jagutic/SpiderBot/InformeTecnico/Imagenes/patas.png

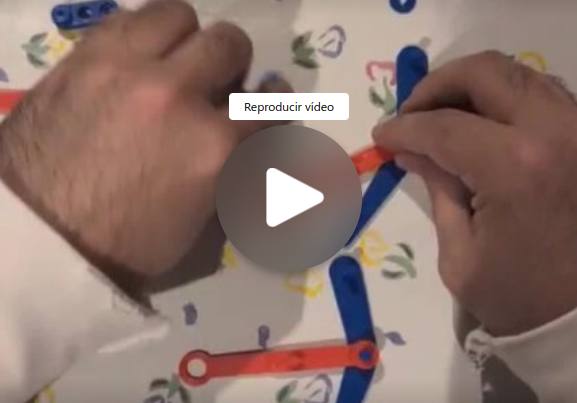
InformeTecnico/Imagenes/patas.png
