jagutic/SpiderBot/InformeTecnico/Imagenes/sim.png

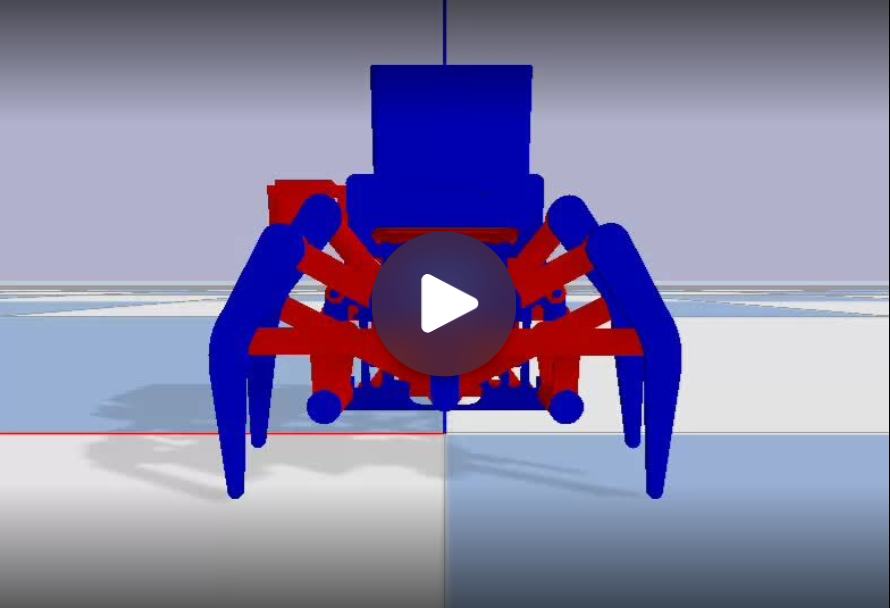
InformeTecnico/Imagenes/sim.png
