jagutic/SpiderBot/InformeTecnico/FreeCad_Stls/AxeMain.stl

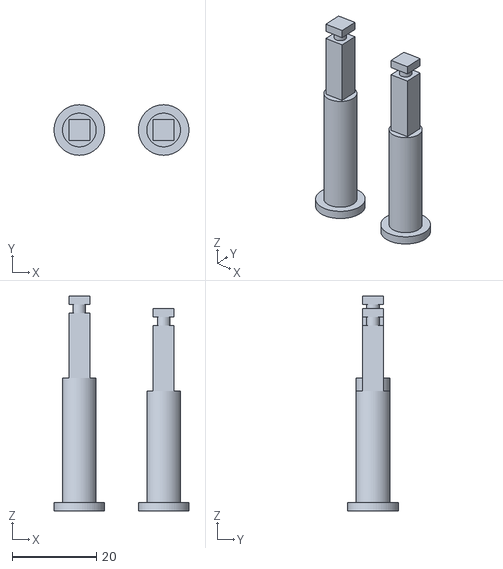
[picture p14: CAD file, 2026-01-07]
InformeTecnico/FreeCad_Stls/AxeMain.stl
32.0 x 12.0 x 51.0
