jagutic/SpiderBot/InformeTecnico/FreeCad_Stls/Medio.stl

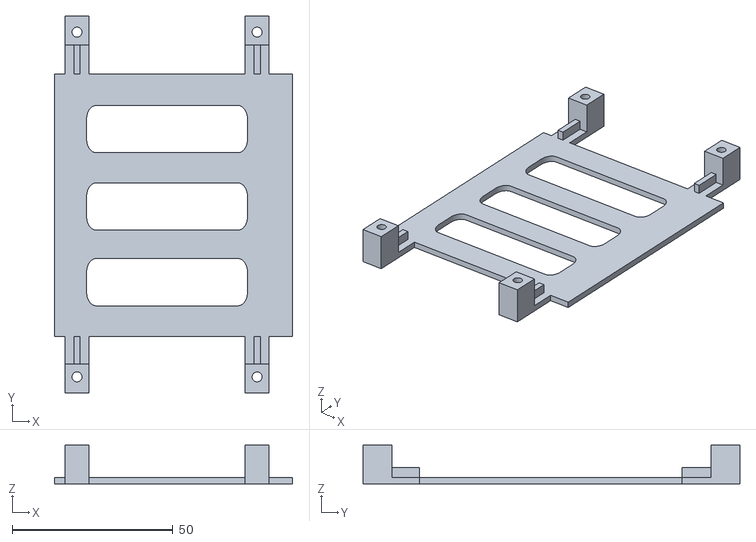
[picture p15: CAD file, 2026-01-09]
InformeTecnico/FreeCad_Stls/Medio.stl
74.0 x 117.2 x 12.0
