jagutic/SpiderBot/InformeTecnico/FreeCad_Stls/Base.stl

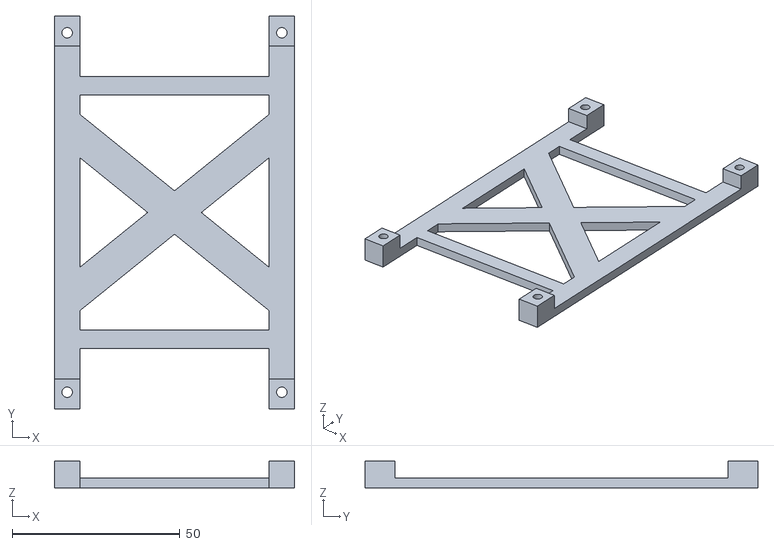
[picture p16: CAD file, 2026-01-09]
InformeTecnico/FreeCad_Stls/Base.stl
71.6 x 117.2 x 8.00
