jagutic/SpiderBot/InformeTecnico/FreeCad_Stls/Caja.stl

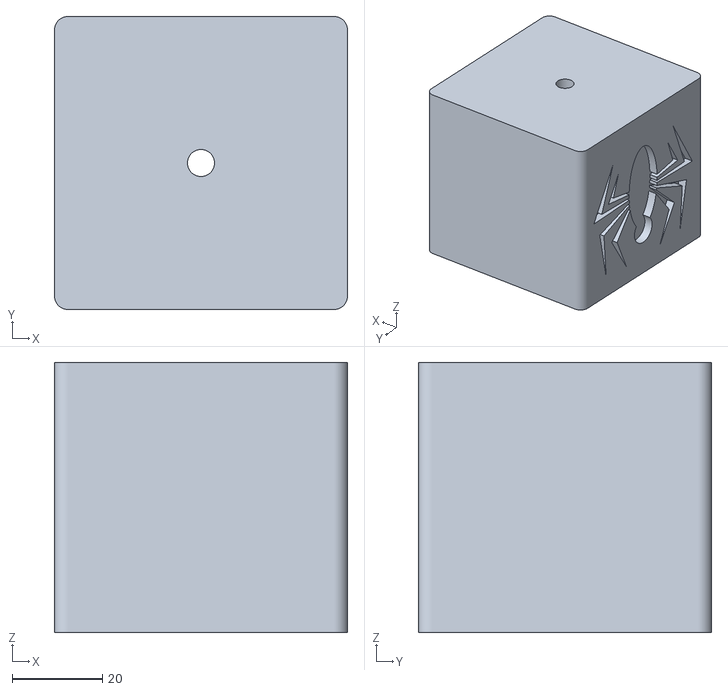
[picture p17: CAD file, 2026-01-07]
InformeTecnico/FreeCad_Stls/Caja.stl
65.0 x 65.0 x 60.0
