jagutic/SpiderBot/InformeTecnico/FreeCad_Stls/Der.stl

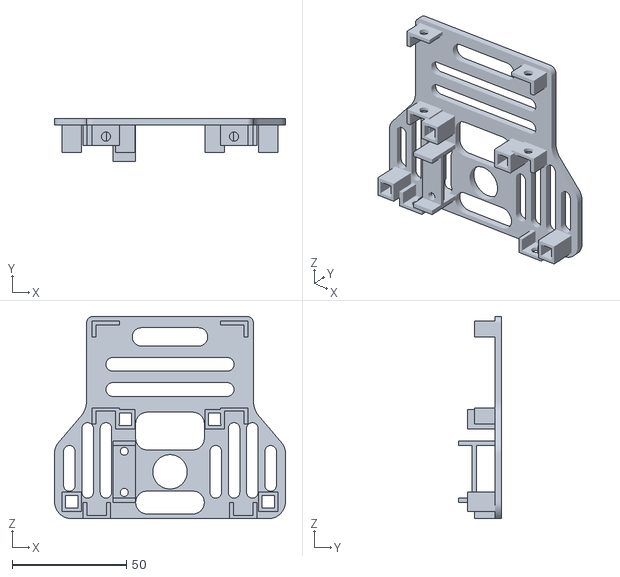
[picture p18: CAD file, 2026-01-07]
InformeTecnico/FreeCad_Stls/Der.stl
101.0 x 19.0 x 88.5
