jagutic/SpiderBot/InformeTecnico/FreeCad_Stls/Leg.stl

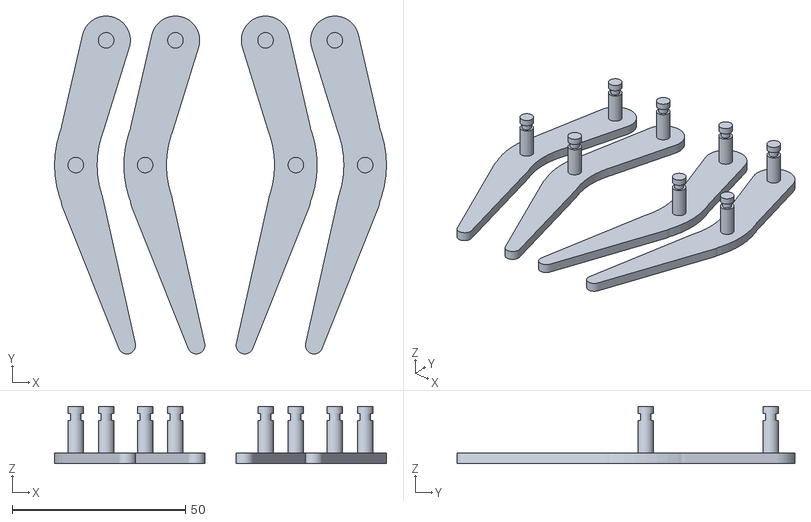
[picture p19: CAD file, 2026-01-07]
InformeTecnico/FreeCad_Stls/Leg.stl
95.8 x 97.5 x 16.5
