jagutic/SpiderBot/InformeTecnico/FreeCad_Stls/AxeDrive.stl

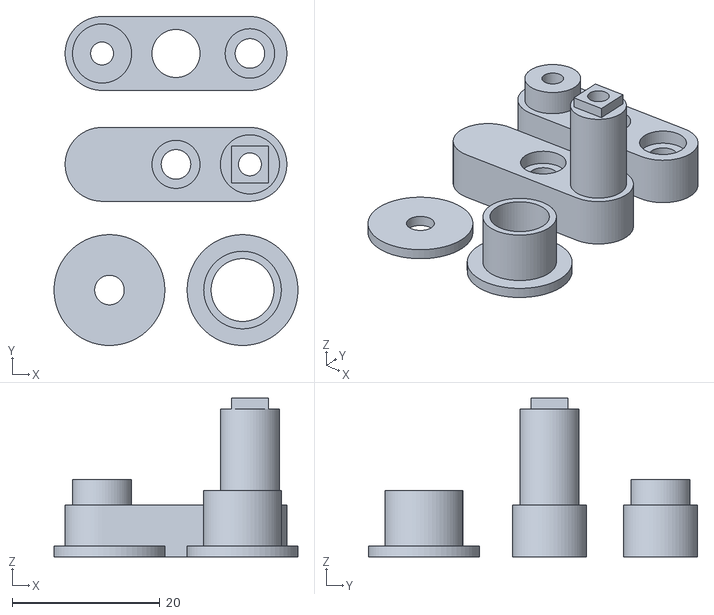
[picture p20: CAD file, 2026-01-07]
InformeTecnico/FreeCad_Stls/AxeDrive.stl
33.0 x 44.5 x 21.5
