jagutic/SpiderBot/InformeTecnico/FreeCad_Stls/Inks1.stl

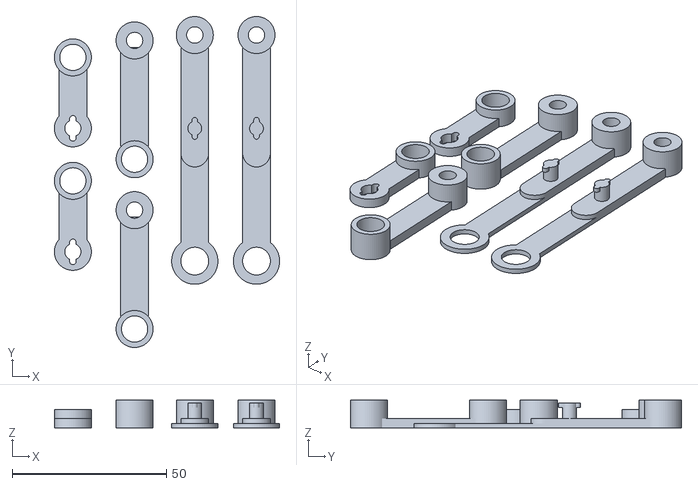
[picture p21: CAD file, 2026-01-07]
InformeTecnico/FreeCad_Stls/Inks1.stl
73.0 x 107.2 x 9.00
