jagutic/SpiderBot/InformeTecnico/FreeCad_Stls/Inks2.stl

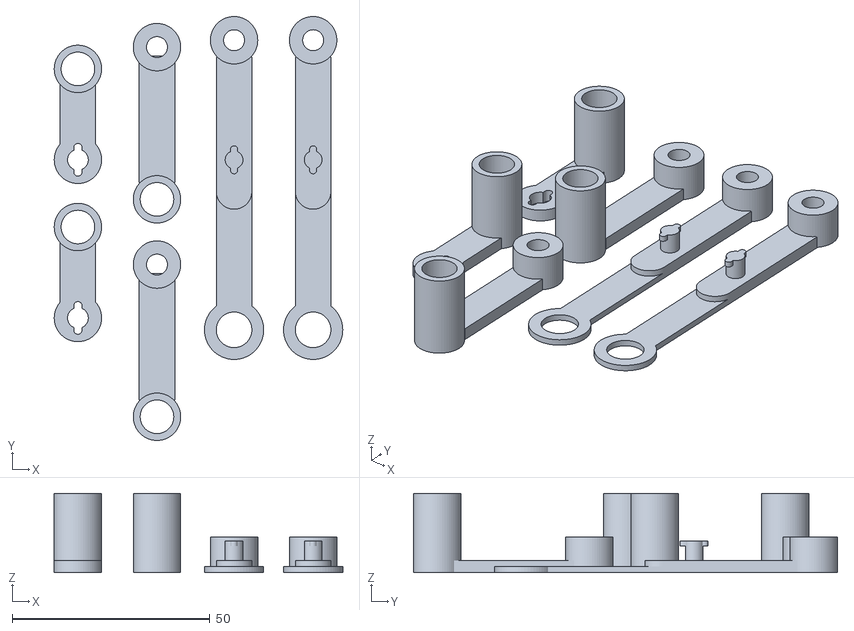
[picture p22: CAD file, 2026-01-07]
InformeTecnico/FreeCad_Stls/Inks2.stl
73.0 x 107.2 x 20.0
