jagutic/SpiderBot/InformeTecnico/FreeCad_Stls/AxeMtr.stl

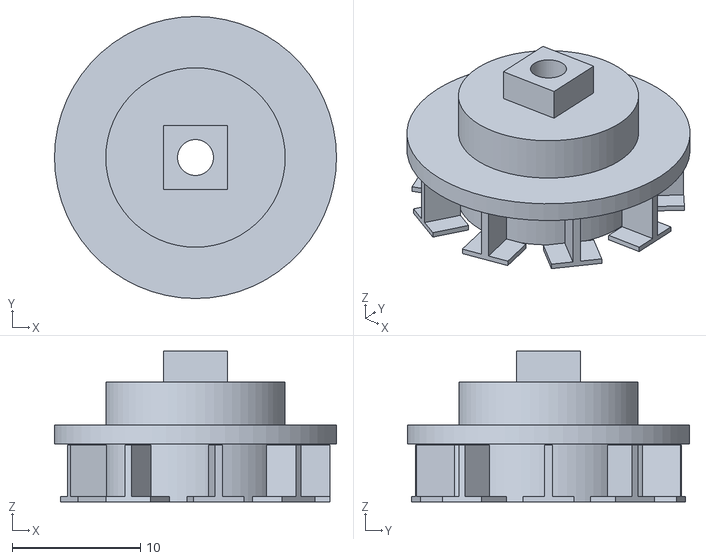
[picture p23: CAD file, 2026-01-07]
InformeTecnico/FreeCad_Stls/AxeMtr.stl
22.0 x 22.0 x 11.8
