jagutic/SpiderBot/InformeTecnico/FreeCad_Stls/Arriba.stl

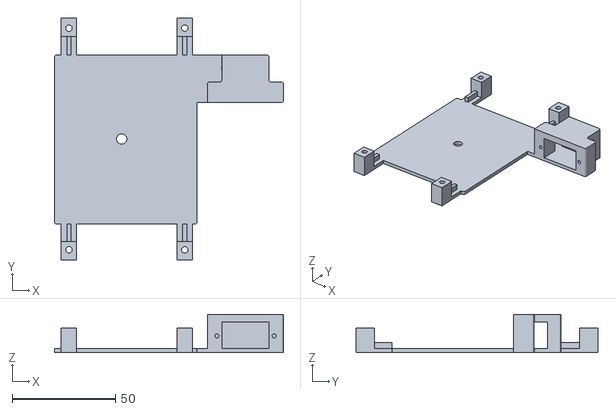
[picture p24: CAD file, 2026-01-07]
InformeTecnico/FreeCad_Stls/Arriba.stl
110.8 x 117.2 x 18.5
