jagutic/SpiderBot/InformeTecnico/FreeCad_Stls/ClipWasherBig.stl

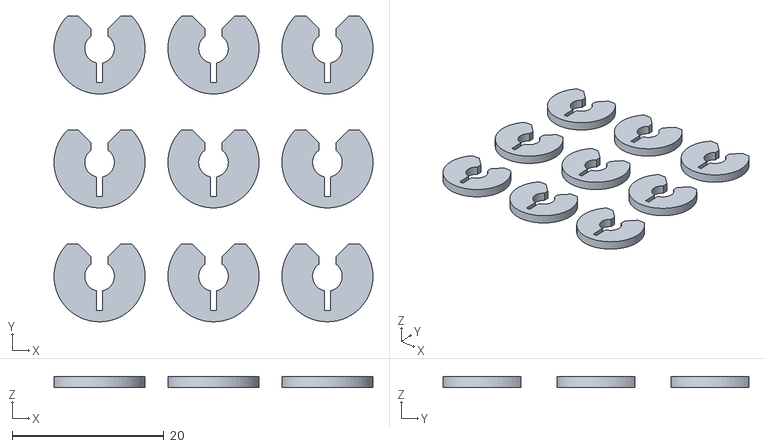
[picture p25: CAD file, 2026-01-07]
InformeTecnico/FreeCad_Stls/ClipWasherBig.stl
42.0 x 40.2 x 1.50
