jagutic/SpiderBot/InformeTecnico/FreeCad_Stls/ClipWasher.stl

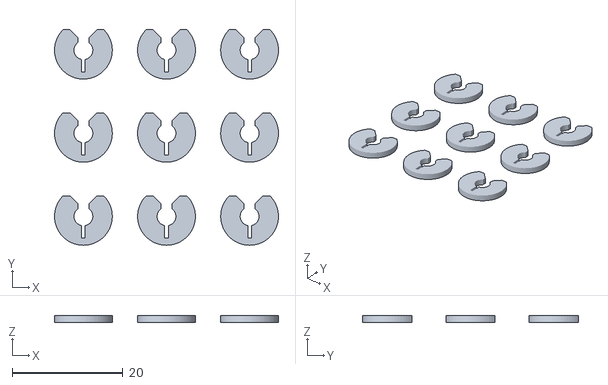
[picture p26: CAD file, 2026-01-07]
InformeTecnico/FreeCad_Stls/ClipWasher.stl
40.4 x 38.9 x 1.30
