jagutic/SpiderBot/(list of files, cad)

Other CAD files:
InformeTecnico/FreeCad_Stls/Izq.stl
