jagutic/SpiderBot/ManualUsuario/Imagenes/IR_Remote_Control.png

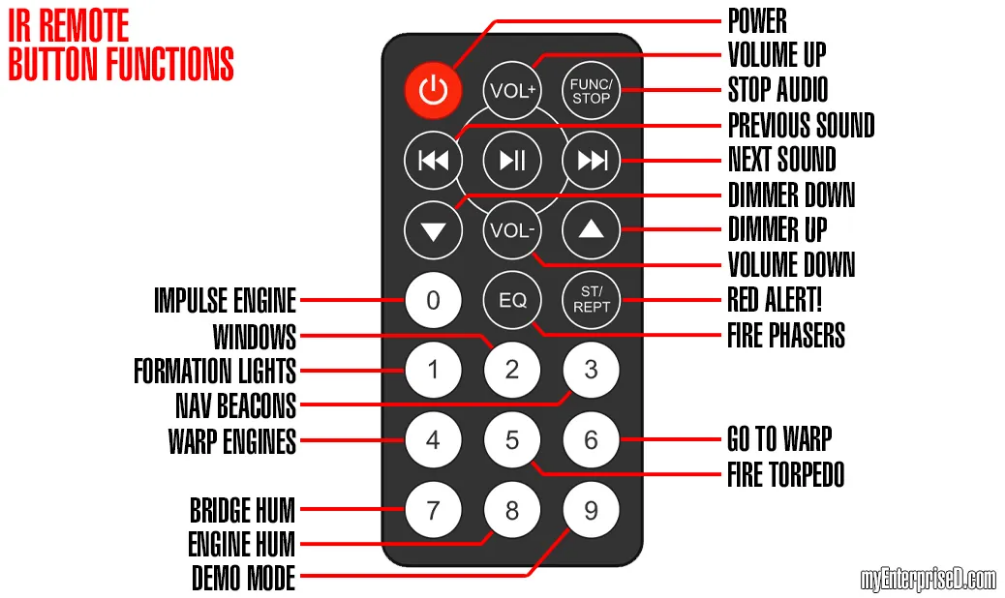
ManualUsuario/Imagenes/IR_Remote_Control.png
