jagutic/SpiderBot/InformeTecnico/simulacion/unnamed/urdf/unnamed.urdf

<robot name="unnamed" version="1.0">
  <joint name="Arriba_link_joint" type="fixed">
    <origin rpy="-3.14159 -0.00000 0.00000" xyz="0.00000 -0.00000 0.00100"/>
    <parent link="Caja_link"/>
    <child link="Arriba_link"/>
  </joint>
  <joint name="Caja_link_joint" type="fixed">
    <origin rpy="3.14159 -0.00000 0.00000" xyz="-0.00250 -0.00000 0.03850"/>
    <parent link="Medio_link"/>
    <child link="Caja_link"/>
  </joint>
  <joint name="Medio_link_joint" type="fixed">
    <origin rpy="0.00000 0.00000 0.00000" xyz="0.00000 0.00000 0.03350"/>
    <parent link="Base_link"/>
    <child link="Medio_link"/>
  </joint>
  <joint name="axe-drive_PCBWay Community.001_link_joint" type="fixed">
    <origin rpy="0.00000 -0.00000 1.57080" xyz="0.00000 0.00400 0.01140"/>
    <parent link="axe-mtr_left.001_link"/>
    <child link="axe-drive_PCBWay_Community.001_link"/>
  </joint>
  <joint name="axe-drive_PCBWay Community.002_link_joint" type="fixed">
    <origin rpy="0.00000 -0.00000 -0.00000" xyz="-0.00390 0.00000 0.01740"/>
    <parent link="axe-drive_PCBWay_Community.001_link"/>
    <child link="axe-drive_PCBWay_Community.002_link"/>
  </joint>
  <joint name="axe-drive_PCBWay Community.004_link_joint" type="fixed">
    <origin rpy="-0.00000 0.00000 -0.00000" xyz="-0.00390 -0.00000 0.01740"/>
    <parent link="axe-drive_PCBWay_Community.003_link"/>
    <child link="axe-drive_PCBWay_Community.004_link"/>
  </joint>
  <joint name="axe-drive_PCBWay_Community.003_link_joint" type="fixed">
    <origin rpy="3.14159 -0.00000 1.57080" xyz="-0.00000 0.00400 -0.01140"/>
    <parent link="axe-mtr_left_link"/>
    <child link="axe-drive_PCBWay_Community.003_link"/>
  </joint>
  <joint name="axe-main_PCBWay Community.001_link_joint" type="fixed">
    <origin rpy="-0.00000 0.00000 0.00000" xyz="-0.04399 -0.01757 -0.01136"/>
    <parent link="left_side_PCBWay_Community_link"/>
    <child link="axe-main_PCBWay_Community.001_link"/>
  </joint>
  <joint name="axe-main_PCBWay Community.003_link_joint" type="fixed">
    <origin rpy="0.00000 0.00000 0.00000" xyz="0.04201 -0.01757 -0.01136"/>
    <parent link="left_side_PCBWay_Community_link"/>
    <child link="axe-main_PCBWay_Community.003_link"/>
  </joint>
  <joint name="axe-main_PCBWay Community.004_link_joint" type="fixed">
    <origin rpy="-0.00000 0.00000 0.00000" xyz="0.01841 0.01833 -0.01246"/>
    <parent link="left_side_PCBWay_Community_link"/>
    <child link="axe-main_PCBWay_Community.004_link"/>
  </joint>
  <joint name="axe-main_PCBWay Community.005_link_joint" type="fixed">
    <origin rpy="-0.00000 -0.00000 -3.14159" xyz="-0.02072 -0.01850 -0.01237"/>
    <parent link="right_side_PCBWay_Community_link"/>
    <child link="axe-main_PCBWay_Community.005_link"/>
  </joint>
  <joint name="axe-main_PCBWay Community.006_link_joint" type="fixed">
    <origin rpy="-0.00000 -0.00000 -3.14159" xyz="0.01808 -0.01850 -0.01237"/>
    <parent link="right_side_PCBWay_Community_link"/>
    <child link="axe-main_PCBWay_Community.006_link"/>
  </joint>
  <joint name="axe-main_PCBWay Community.007_link_joint" type="fixed">
    <origin rpy="-0.00000 -0.00000 -3.14159" xyz="0.04168 0.01740 -0.01127"/>
    <parent link="right_side_PCBWay_Community_link"/>
    <child link="axe-main_PCBWay_Community.007_link"/>
  </joint>
  <joint name="axe-main_PCBWay Community_link_joint" type="fixed">
    <origin rpy="-0.00000 0.00000 0.00000" xyz="-0.02039 0.01833 -0.01246"/>
    <parent link="left_side_PCBWay_Community_link"/>
    <child link="axe-main_PCBWay_Community_link"/>
  </joint>
  <joint name="axe-main_PCBWay_Community.002_link_joint" type="fixed">
    <origin rpy="-0.00000 -0.00000 -3.14159" xyz="-0.04432 0.01740 -0.01127"/>
    <parent link="right_side_PCBWay_Community_link"/>
    <child link="axe-main_PCBWay_Community.002_link"/>
  </joint>
  <joint name="axe-mtr_left.001_link_joint" type="continuous">
    <limit lower="0" upper="0" effort="0.00000" velocity="0.00000"/>
    <origin rpy="3.14159 0.00000 3.14159" xyz="-0.00132 0.00440 0.00053"/>
    <parent link="right_side_PCBWay_Community_link"/>
    <child link="axe-mtr_left.001_link"/>
    <axis xyz="0.00000 0.00000 1.00000"/>
  </joint>
  <joint name="axe-mtr_left_link_joint" type="continuous">
    <limit lower="0" upper="0" effort="0.00000" velocity="1000.00000"/>
    <origin rpy="0.00000 -0.00000 3.14159" xyz="-0.00099 -0.00457 0.00044"/>
    <parent link="left_side_PCBWay_Community_link"/>
    <child link="axe-mtr_left_link"/>
    <axis xyz="0.00000 0.00000 1.00000"/>
  </joint>
  <joint name="inks_1_PCBWay Community.001_link_joint" type="continuous">
    <limit lower="0" upper="0" effort="0.00000" velocity="0.00000"/>
    <origin rpy="-0.00000 0.00000 -0.68167" xyz="-0.00003 0.00019 0.00561"/>
    <parent link="axe-main_PCBWay_Community.005_link"/>
    <child link="inks_1_PCBWay_Community.001_link"/>
    <axis xyz="0.00000 0.00000 1.00000"/>
  </joint>
  <joint name="inks_1_PCBWay Community.003_link_joint" type="continuous">
    <limit lower="0" upper="0" effort="0.00000" velocity="1000.00000"/>
    <origin rpy="3.14159 -0.00000 -2.45992" xyz="-0.00003 0.00019 0.00561"/>
    <parent link="axe-main_PCBWay_Community.004_link"/>
    <child link="inks_1_PCBWay_Community.003_link"/>
    <axis xyz="0.00000 0.00000 1.00000"/>
  </joint>
  <joint name="inks_1_PCBWay Community.004_link_joint" type="continuous">
    <limit lower="0" upper="0" effort="0.00000" velocity="0.00000"/>
    <origin rpy="0.00000 0.00000 0.68168" xyz="0.00003 0.00019 0.00561"/>
    <parent link="axe-main_PCBWay_Community_link"/>
    <child link="inks_1_PCBWay_Community.004_link"/>
    <axis xyz="0.00000 0.00000 1.00000"/>
  </joint>
  <joint name="inks_1_PCBWay Community.005_link_joint" type="continuous">
    <limit lower="0" upper="0" effort="0.00000" velocity="0.00000"/>
    <origin rpy="-0.00000 -0.00000 -2.95933" xyz="0.00021 -0.00008 0.00567"/>
    <parent link="axe-main_PCBWay_Community.003_link"/>
    <child link="inks_1_PCBWay_Community.005_link"/>
    <axis xyz="0.00000 0.00000 1.00000"/>
  </joint>
  <joint name="inks_1_PCBWay Community.006_link_joint" type="continuous">
    <limit lower="0" upper="0" effort="0.00000" velocity="0.00000"/>
    <origin rpy="3.14159 0.00000 2.95933" xyz="-0.00019 0.00009 0.01292"/>
    <parent link="inks_2_PCBWay_Community.006_link"/>
    <child link="inks_1_PCBWay_Community.006_link"/>
    <axis xyz="0.00000 0.00000 1.00000"/>
  </joint>
  <joint name="inks_1_PCBWay Community.008_link_joint" type="continuous">
    <limit lower="0" upper="0" effort="0.00000" velocity="0.00000"/>
    <origin rpy="-0.00000 -0.00000 2.95933" xyz="-0.00021 -0.00000 0.00467"/>
    <parent link="axe-main_PCBWay_Community.001_link"/>
    <child link="inks_1_PCBWay_Community.008_link"/>
    <axis xyz="0.00000 0.00000 1.00000"/>
  </joint>
  <joint name="inks_1_PCBWay Community.009_link_joint" type="continuous">
    <limit lower="0" upper="0" effort="0.00000" velocity="0.00000"/>
    <origin rpy="-0.00000 -0.00000 2.95933" xyz="-0.00021 -0.00000 0.00467"/>
    <parent link="axe-main_PCBWay_Community.007_link"/>
    <child link="inks_1_PCBWay_Community.009_link"/>
    <axis xyz="0.00000 0.00000 1.00000"/>
  </joint>
  <joint name="inks_1_PCBWay Community.010_link_joint" type="continuous">
    <limit lower="0" upper="0" effort="0.00000" velocity="0.00000"/>
    <origin rpy="0.00000 -0.00000 2.22205" xyz="-0.00000 0.00000 0.00000"/>
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
    <child link="inks_2_PCBWay_Community.008_link"/>
    <axis xyz="0.00000 0.00000 1.00000"/>
  </joint>
  <joint name="inks_2_PCBWay Community.009_link_joint" type="continuous">
    <limit lower="0" upper="0" effort="0.00000" velocity="0.00000"/>
    <origin rpy="3.14159 -0.00000 0.00000" xyz="-0.00002 0.00001 -0.00725"/>
    <parent link="axe-main_PCBWay_Community.001_link"/>
    <child link="inks_2_PCBWay_Community.009_link"/>
    <axis xyz="0.00000 0.00000 1.00000"/>
  </joint>
  <joint name="inks_2_PCBWay Community.010_link_joint" type="continuous">
    <limit lower="0" upper="0" effort="0.00000" velocity="0.00000"/>
    <origin rpy="0.00000 0.00000 3.14159" xyz="-0.01011 0.00000 0.00455"/>
    <parent link="axe-drive_PCBWay_Community.002_link"/>
    <child link="inks_2_PCBWay_Community.010_link"/>
    <axis xyz="0.00000 0.00000 1.00000"/>
  </joint>
  <joint name="inks_2_PCBWay Community.012_link_joint" type="continuous">
    <limit lower="0" upper="0" effort="0.00000" velocity="0.00000"/>
    <origin rpy="-0.00000 0.00000 3.14159" xyz="-0.00002 0.00001 -0.00725"/>
    <parent link="axe-main_PCBWay_Community.007_link"/>
    <child link="inks_2_PCBWay_Community.012_link"/>
    <axis xyz="0.00000 0.00000 1.00000"/>
  </joint>
  <joint name="inks_2_PCBWay_Community.001_link_joint" type="continuous">
    <limit lower="0" upper="0" effort="0.00000" velocity="0.00000"/>
    <origin rpy="-3.14159 0.00000 -0.00000" xyz="-0.01011 0.00000 0.00300"/>
    <parent link="axe-drive_PCBWay_Community.004_link"/>
    <child link="inks_2_PCBWay_Community.001_link"/>
    <axis xyz="0.00000 0.00000 1.00000"/>
  </joint>
  <joint name="inks_2_PCBWay_Community.011_link_joint" type="continuous">
    <limit lower="0" upper="0" effort="0.00000" velocity="0.00000"/>
    <origin rpy="-3.14159 -0.00000 2.06821" xyz="0.00003 -0.00011 -0.01890"/>
    <parent link="axe-main_PCBWay_Community.006_link"/>
    <child link="inks_2_PCBWay_Community.011_link"/>
    <axis xyz="0.00000 0.00000 1.00000"/>
  </joint>
  <joint name="left_side_PCBWay_Community_link_joint" type="fixed">
    <origin rpy="1.57080 0.00000 0.00000" xyz="0.00099 0.05864 0.02357"/>
    <parent link="Base_link"/>
    <child link="left_side_PCBWay_Community_link"/>
  </joint>
  <joint name="leg_PCBWay Community.001_link_joint" type="continuous">
    <limit lower="0" upper="0" effort="0.00000" velocity="1000.00000"/>
    <origin rpy="-0.00000 0.00000 1.51844" xyz="0.00021 0.07365 0.01349"/>
    <parent link="inks_1_PCBWay_Community.002_link"/>
    <child link="leg_PCBWay_Community.001_link"/>
    <axis xyz="0.00000 0.00000 1.00000"/>
  </joint>
  <joint name="leg_PCBWay Community.002_link_joint" type="continuous">
    <limit lower="0" upper="0" effort="0.00000" velocity="0.00000"/>
    <origin rpy="-0.00000 -0.00000 -1.52909" xyz="-0.00021 0.07365 0.01349"/>
    <parent link="inks_1_PCBWay_Community.010_link"/>
    <child link="leg_PCBWay_Community.002_link"/>
    <axis xyz="0.00000 0.00000 1.00000"/>
  </joint>
  <joint name="leg_PCBWay Community.004_link_joint" type="continuous">
    <limit lower="0" upper="0" effort="0.00000" velocity="0.00000"/>
    <origin rpy="-0.00000 0.00000 1.51844" xyz="0.00021 0.07365 0.01349"/>
    <parent link="inks_1_PCBWay_Community.012_link"/>
    <child link="leg_PCBWay_Community.004_link"/>
    <axis xyz="0.00000 0.00000 1.00000"/>
  </joint>
  <joint name="leg_PCBWay Community.005_link_joint" type="continuous">
    <limit lower="0" upper="0" effort="0.00000" velocity="0.00000"/>
    <origin rpy="-3.14159 0.00000 1.23744" xyz="-0.00000 -0.07325 -0.01380"/>
    <parent link="inks_2_PCBWay_Community.007_link"/>
    <child link="leg_PCBWay_Community.005_link"/>
    <axis xyz="0.00000 0.00000 1.00000"/>
  </joint>
  <joint name="leg_PCBWay Community.006_link_joint" type="continuous">
    <limit lower="0" upper="0" effort="0.00000" velocity="0.00000"/>
    <origin rpy="-3.14159 0.00000 2.44863" xyz="0.05845 -0.04482 -0.01349"/>
    <parent link="inks_1_PCBWay_Community.011_link"/>
    <child link="leg_PCBWay_Community.006_link"/>
    <axis xyz="0.00000 0.00000 1.00000"/>
  </joint>
  <joint name="leg_PCBWay Community.007_link_joint" type="continuous">
    <limit lower="0" upper="0" effort="0.00000" velocity="0.00000"/>
    <origin rpy="0.00000 0.00000 1.90415" xyz="0.00000 0.07325 0.01225"/>
    <parent link="inks_2_PCBWay_Community.003_link"/>
    <child link="leg_PCBWay_Community.007_link"/>
    <axis xyz="0.00000 0.00000 1.00000"/>
  </joint>
  <joint name="leg_PCBWay Community.008_link_joint" type="continuous">
    <limit lower="0" upper="0" effort="0.00000" velocity="0.00000"/>
    <origin rpy="-3.14159 -0.00000 1.23744" xyz="-0.00000 -0.07325 -0.01380"/>
    <parent link="inks_2_PCBWay_Community.010_link"/>
    <child link="leg_PCBWay_Community.008_link"/>
    <axis xyz="0.00000 0.00000 1.00000"/>
  </joint>
  <joint name="leg_PCBWay_Community.003_link_joint" type="continuous">
    <limit lower="0" upper="0" effort="0.00000" velocity="0.00000"/>
    <origin rpy="0.00000 0.00000 1.90415" xyz="0.00000 0.07325 0.01225"/>
    <parent link="inks_2_PCBWay_Community.001_link"/>
    <child link="leg_PCBWay_Community.003_link"/>
    <axis xyz="0.00000 0.00000 1.00000"/>
  </joint>
  <joint name="right_side_PCBWay Community_link_joint" type="fixed">
    <origin rpy="-1.57080 0.00000 0.00000" xyz="0.00132 -0.05873 0.02340"/>
    <parent link="Base_link"/>
    <child link="right_side_PCBWay_Community_link"/>
  </joint>
  <link name="Arriba_link">
    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
  </link>
  <link name="Base_link">
    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
    <inertial>
      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
      <origin rpy="0.00000 0.00000 0.00000" xyz="0.00001 -0.00000 0.00189"/>
      <mass value="0.10000"/>
    </inertial>
    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
  </link>
  <link name="Caja_link">
    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
  </link>
  <link name="Medio_link">
    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
    <inertial>
      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
      <origin rpy="0.00000 0.00000 0.00000" xyz="0.00213 -0.00002 0.00231"/>
      <mass value="20.00000"/>
    </inertial>
    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
  </link>
  <link name="axe-drive_PCBWay_Community.001_link">
    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
    <inertial>
      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
      <origin rpy="0.00000 0.00000 0.00000" xyz="-0.00170 0.00000 -0.00150"/>
      <mass value="0.10000"/>
    </inertial>
    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
  </link>
  <link name="axe-drive_PCBWay_Community.002_link">
    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
    <inertial>
      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
      <origin rpy="0.00000 0.00000 0.00000" xyz="-0.00169 0.00000 -0.00105"/>
      <mass value="0.10000"/>
    </inertial>
    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
  </link>
  <link name="axe-drive_PCBWay_Community.003_link">
    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
    <inertial>
      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
      <origin rpy="0.00000 0.00000 0.00000" xyz="-0.00170 0.00000 -0.00150"/>
      <mass value="0.10000"/>
    </inertial>
    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
  </link>
  <link name="axe-drive_PCBWay_Community.004_link">
    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
    <inertial>
      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
      <origin rpy="0.00000 0.00000 0.00000" xyz="-0.00169 0.00000 -0.00105"/>
      <mass value="0.10000"/>
    </inertial>
    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
  </link>
  <link name="axe-main_PCBWay_Community.001_link">
    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
    <inertial>
      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
      <origin rpy="0.00000 0.00000 0.00000" xyz="0.00000 -0.00000 -0.00262"/>
      <mass value="0.10000"/>
    </inertial>
    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
  </link>
  <link name="axe-main_PCBWay_Community.002_link">
    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
    <inertial>
      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
      <origin rpy="0.00000 0.00000 0.00000" xyz="-0.00000 0.00000 -0.00262"/>
      <mass value="0.10000"/>
    </inertial>
    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
  </link>
  <link name="axe-main_PCBWay_Community.003_link">
    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
    <inertial>
      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
      <origin rpy="0.00000 0.00000 0.00000" xyz="0.00000 0.00000 -0.00262"/>
      <mass value="0.10000"/>
    </inertial>
    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
  </link>
  <link name="axe-main_PCBWay_Community.004_link">
    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
    <inertial>
      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
      <origin rpy="0.00000 0.00000 0.00000" xyz="0.00000 0.00000 -0.00277"/>
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
      <mass value="0.10000"/>
    </inertial>
    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
  </link>
  <link name="right_side_PCBWay_Community_link">
    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
    <inertial>
      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
      <origin rpy="0.00000 0.00000 0.00000" xyz="-0.00229 -0.01470 0.00004"/>
      <mass value="0.10000"/>
    </inertial>
    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
  </link>
  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
</robot>
