jagutic/SpiderBot/InformeTecnico/Planos/All-Page.pdf

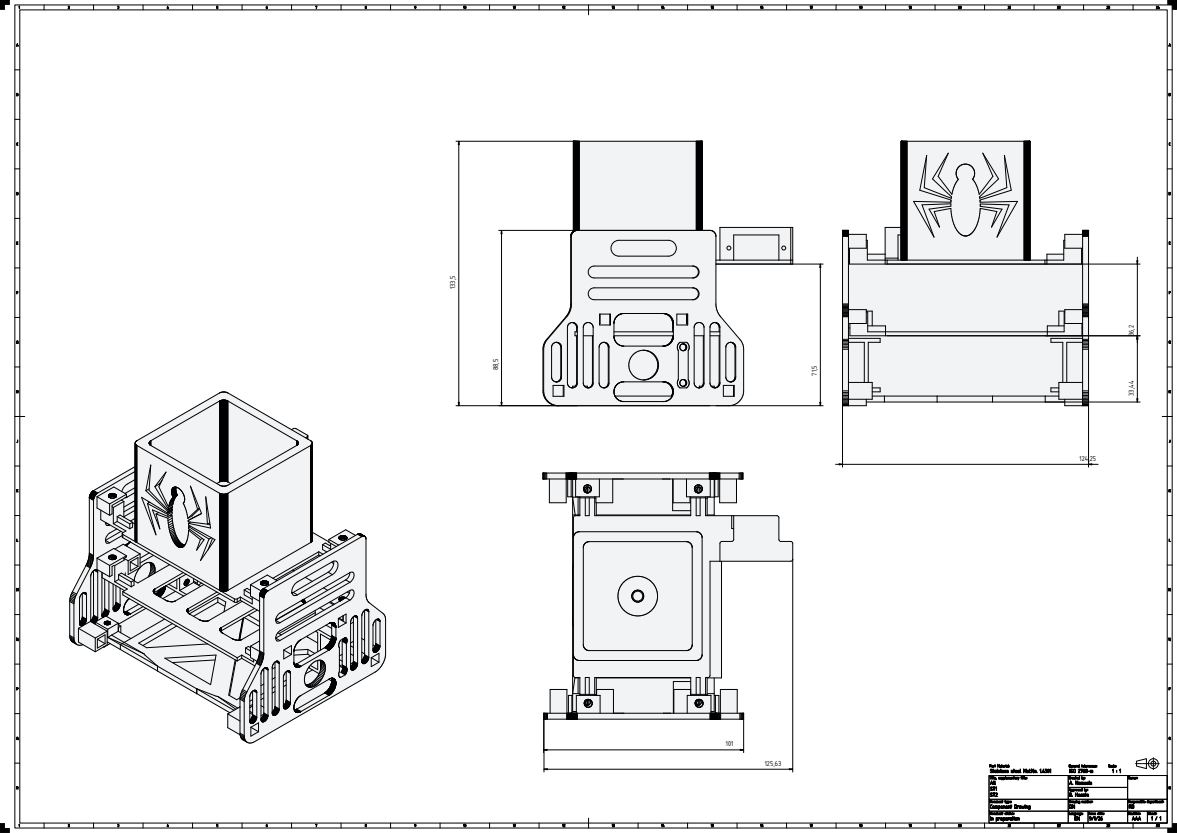
[picture p29: page 1]
