jagutic/SpiderBot/InformeTecnico/Planos/arriba.pdf

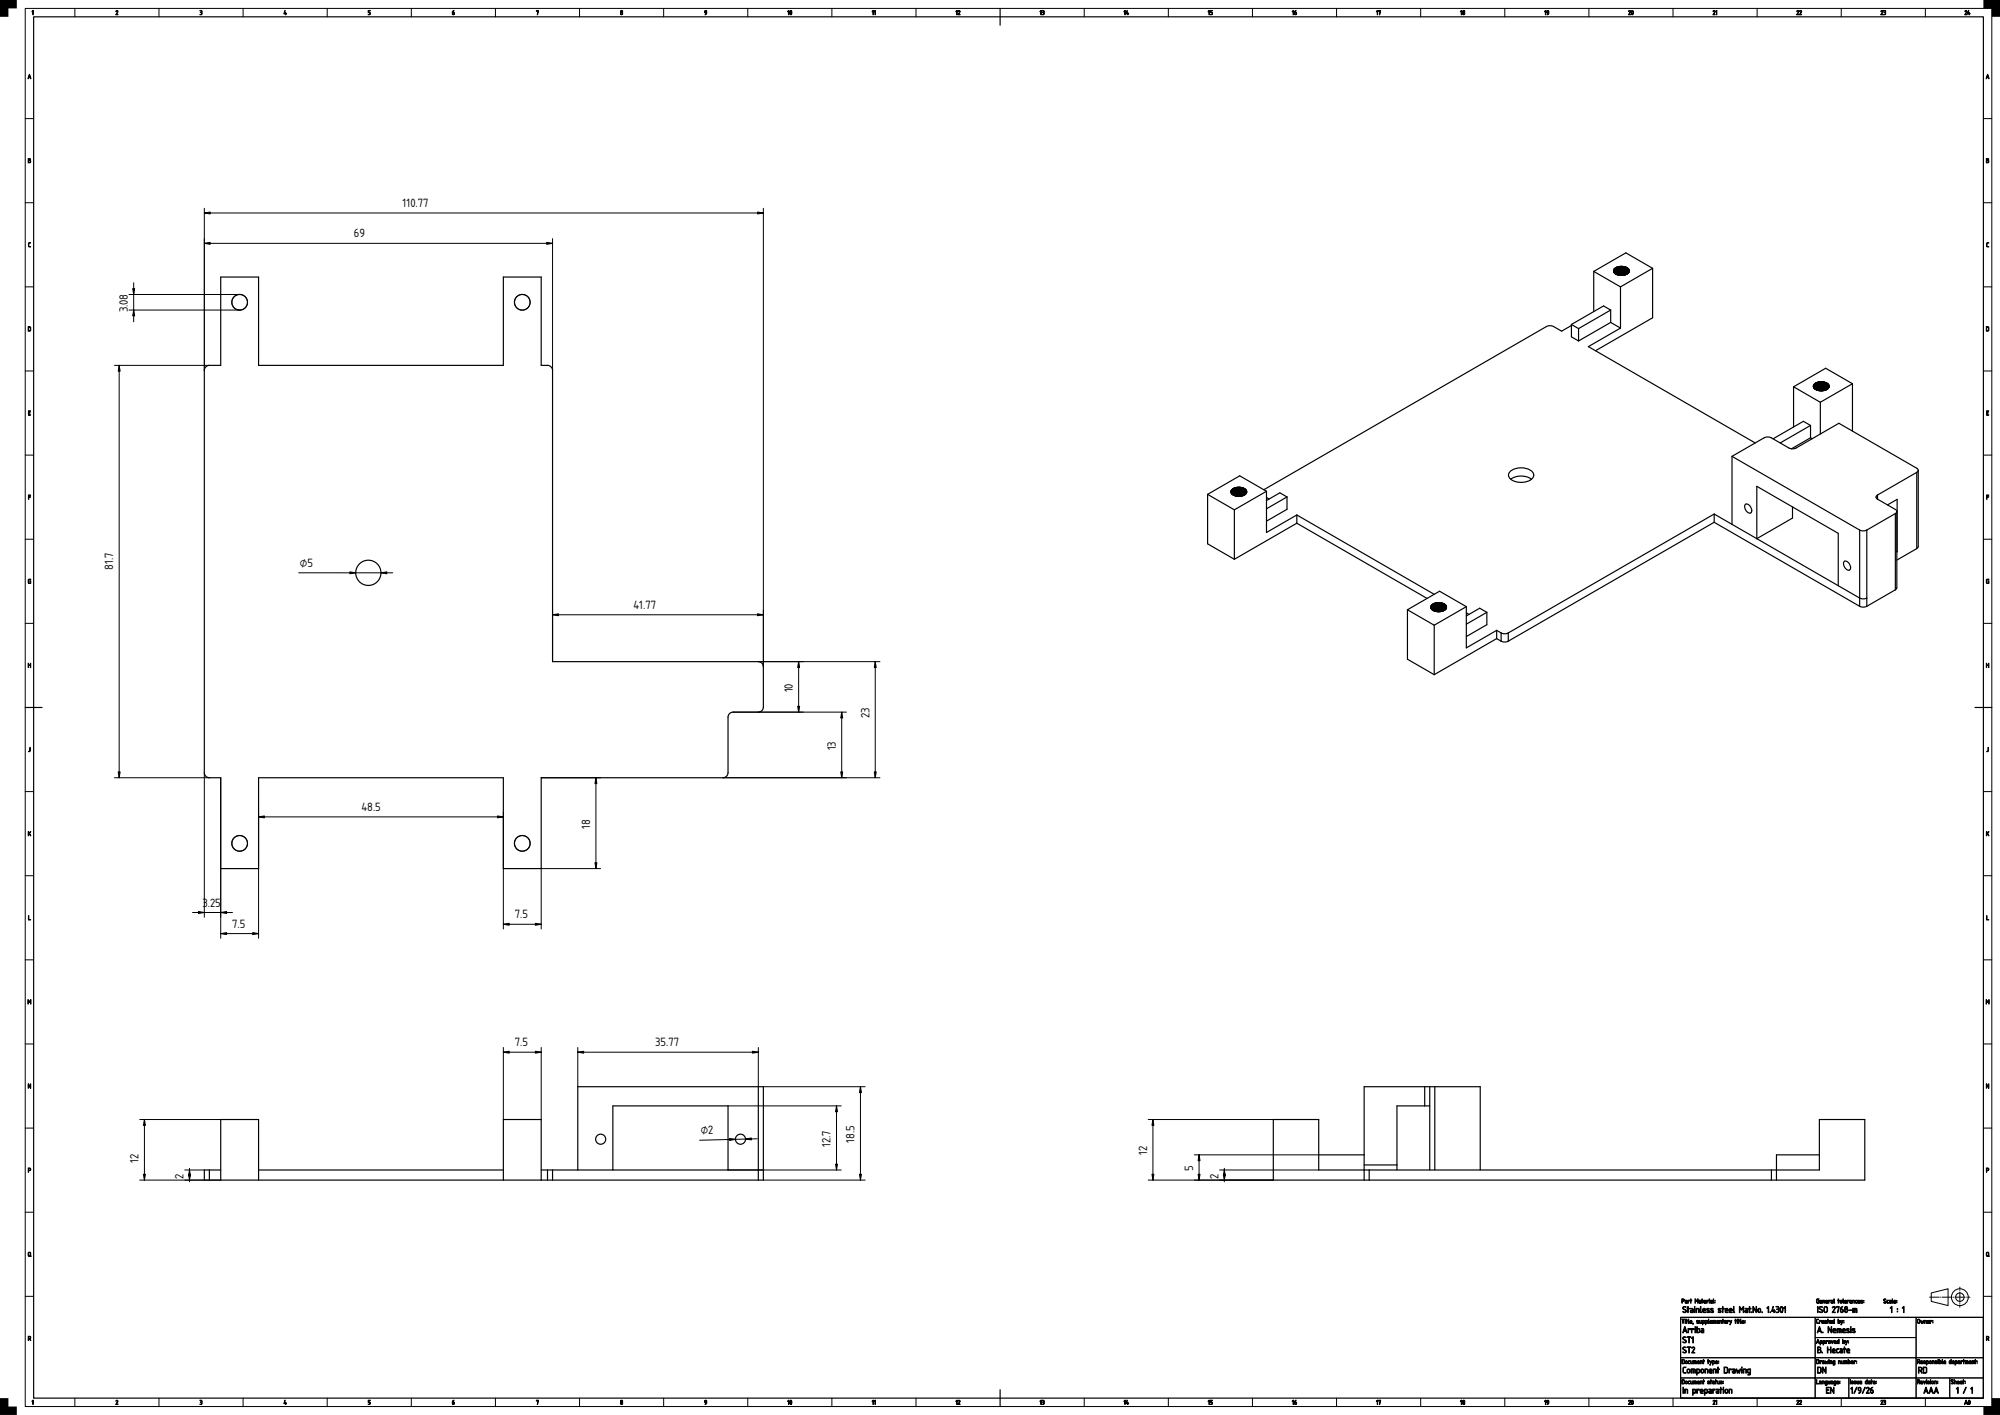
[picture p30: page 1]
