jagutic/SpiderBot/InformeTecnico/Planos/AxeDrive.pdf

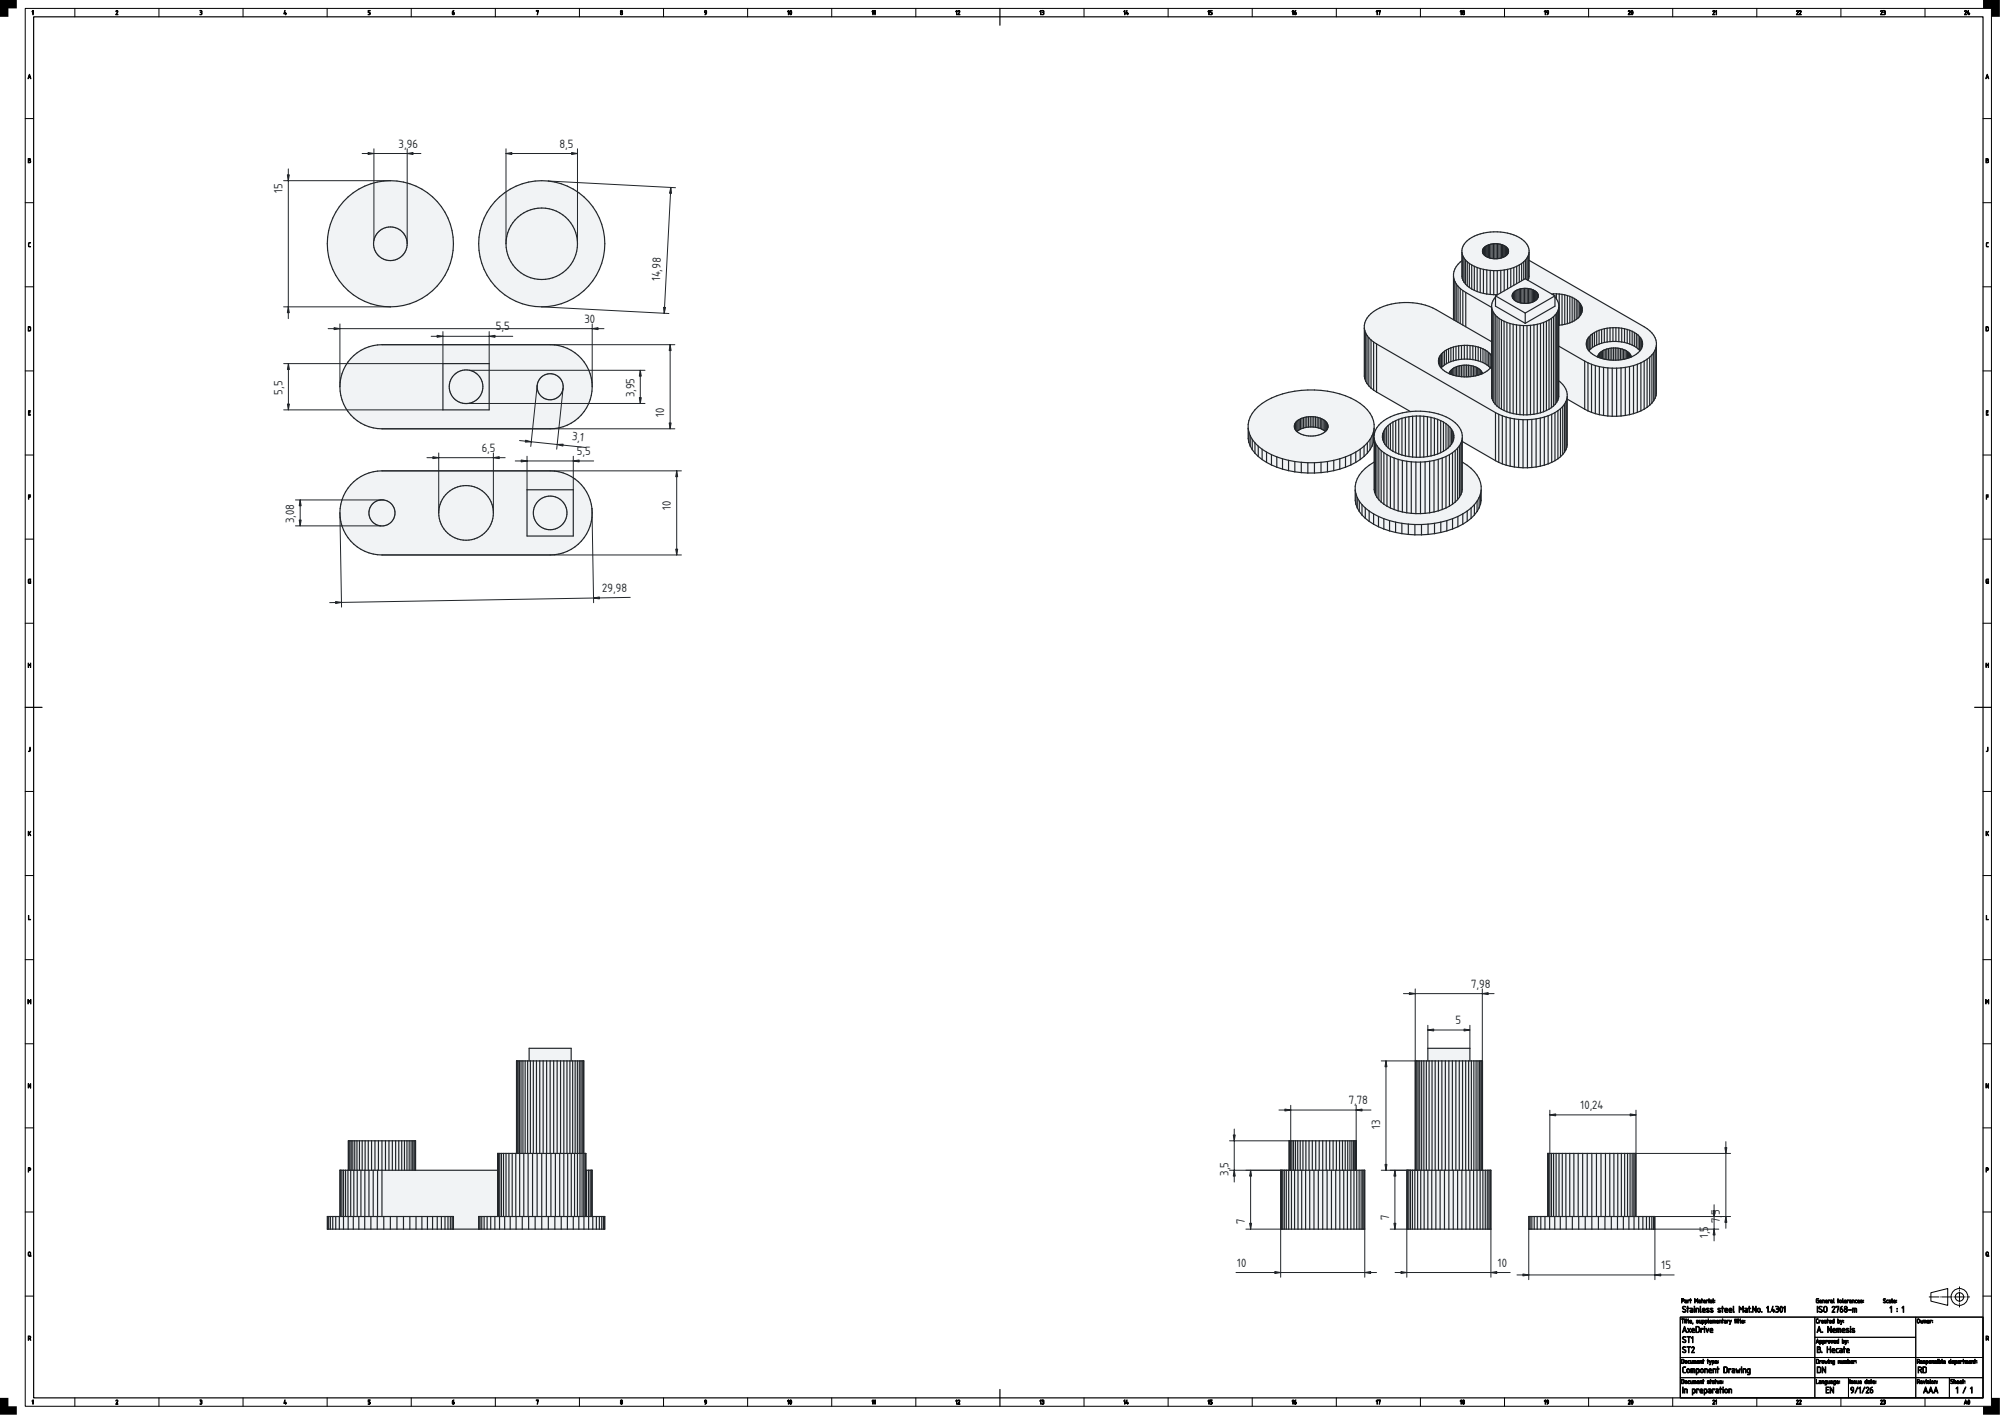
[picture p31: page 1]
