jagutic/SpiderBot/InformeTecnico/Planos/AxeMain.pdf

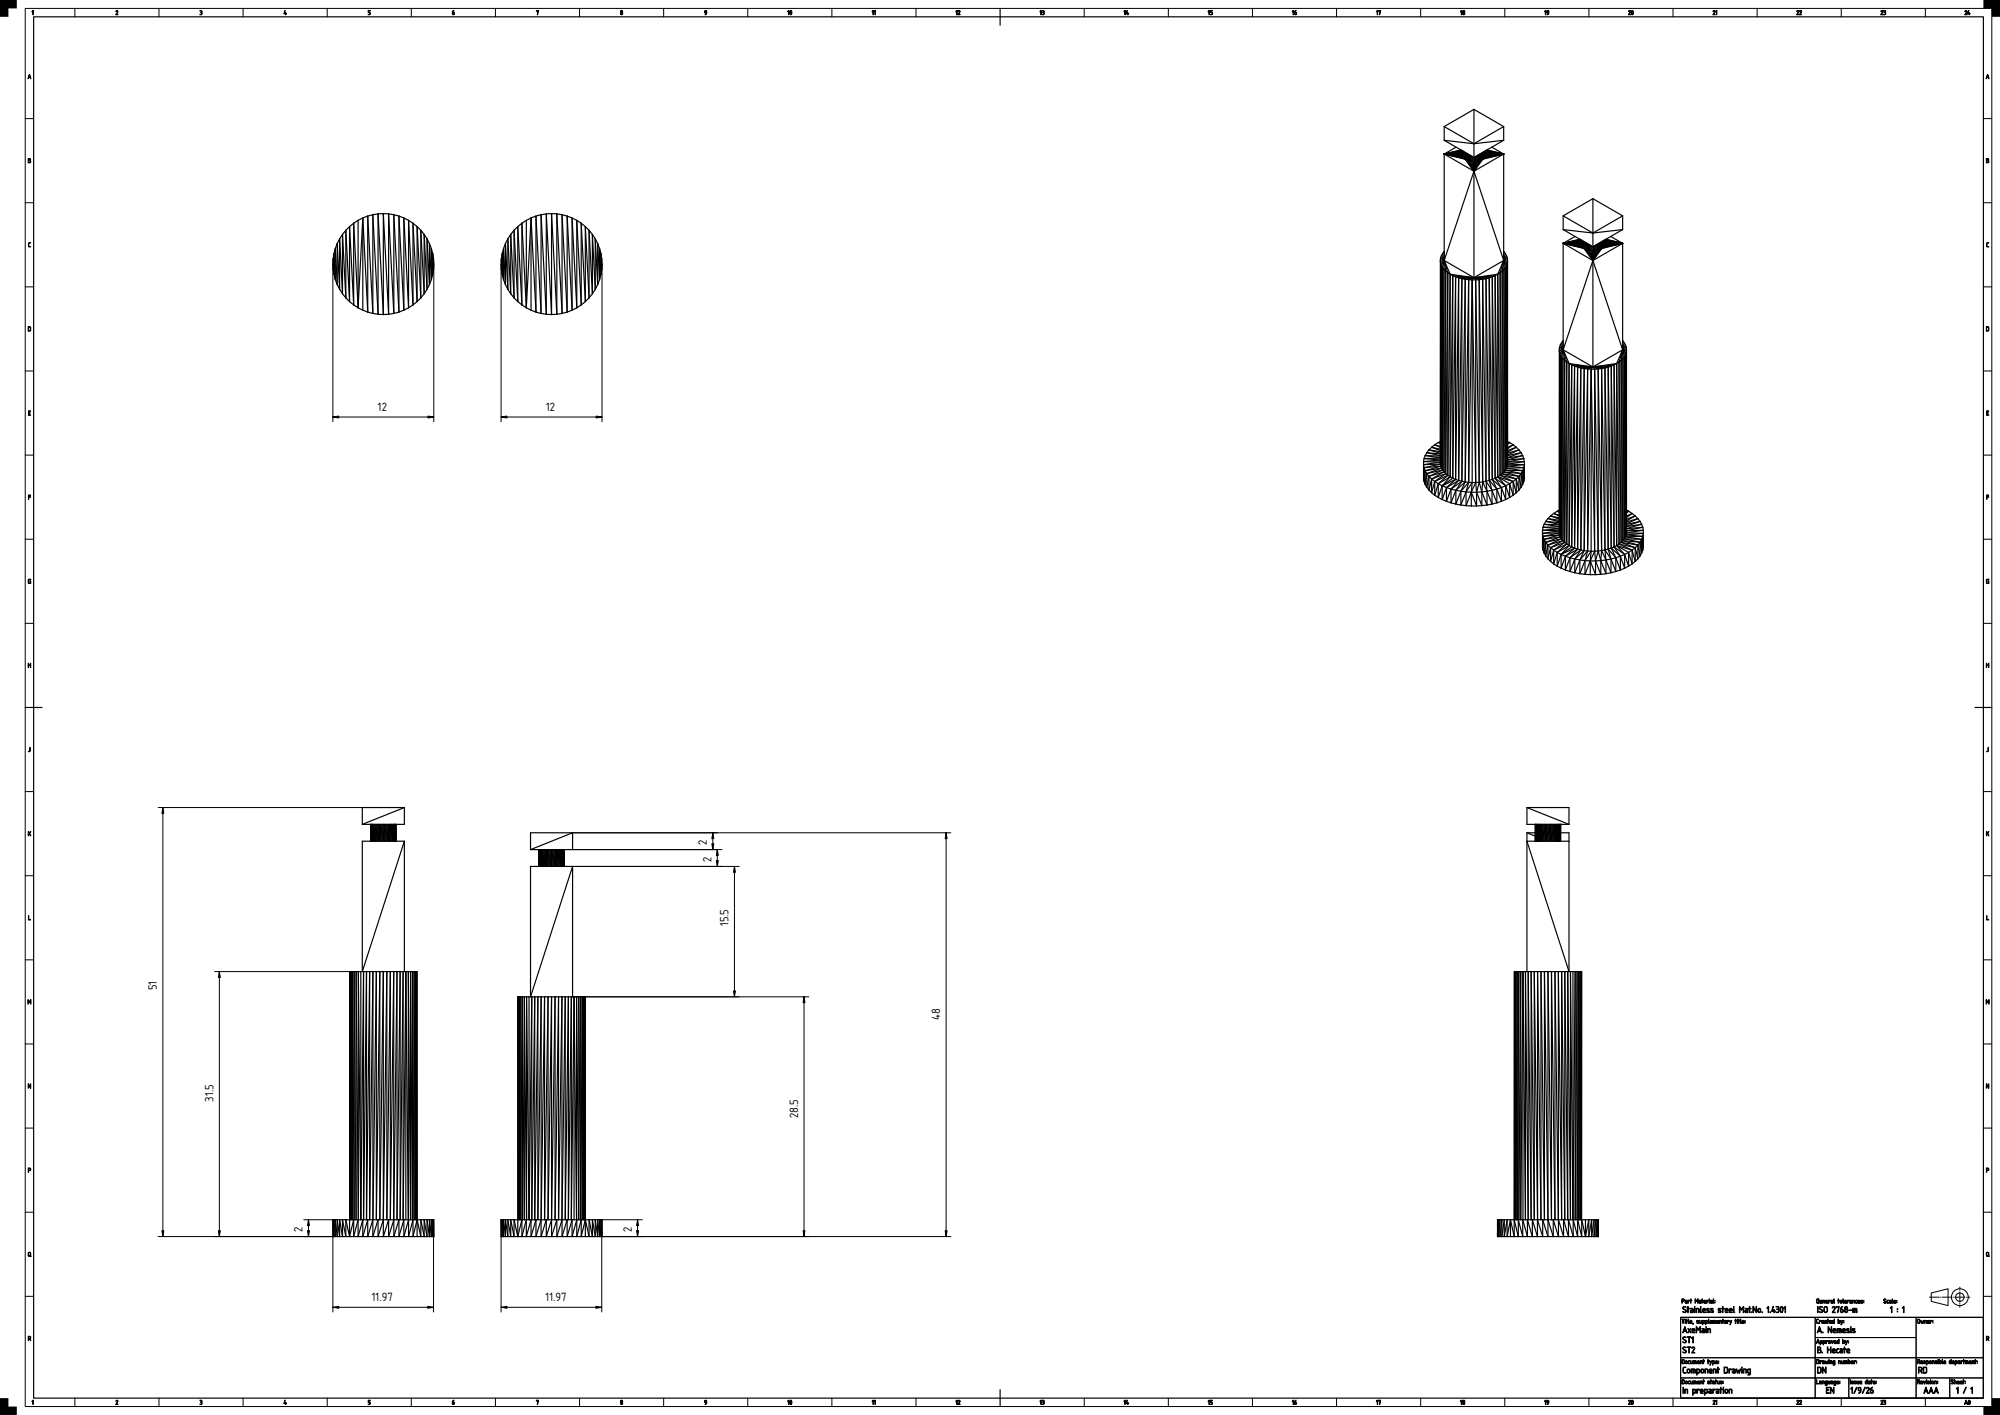
[picture p32: page 1]
