jagutic/SpiderBot/InformeTecnico/Planos/AxeMtr.pdf

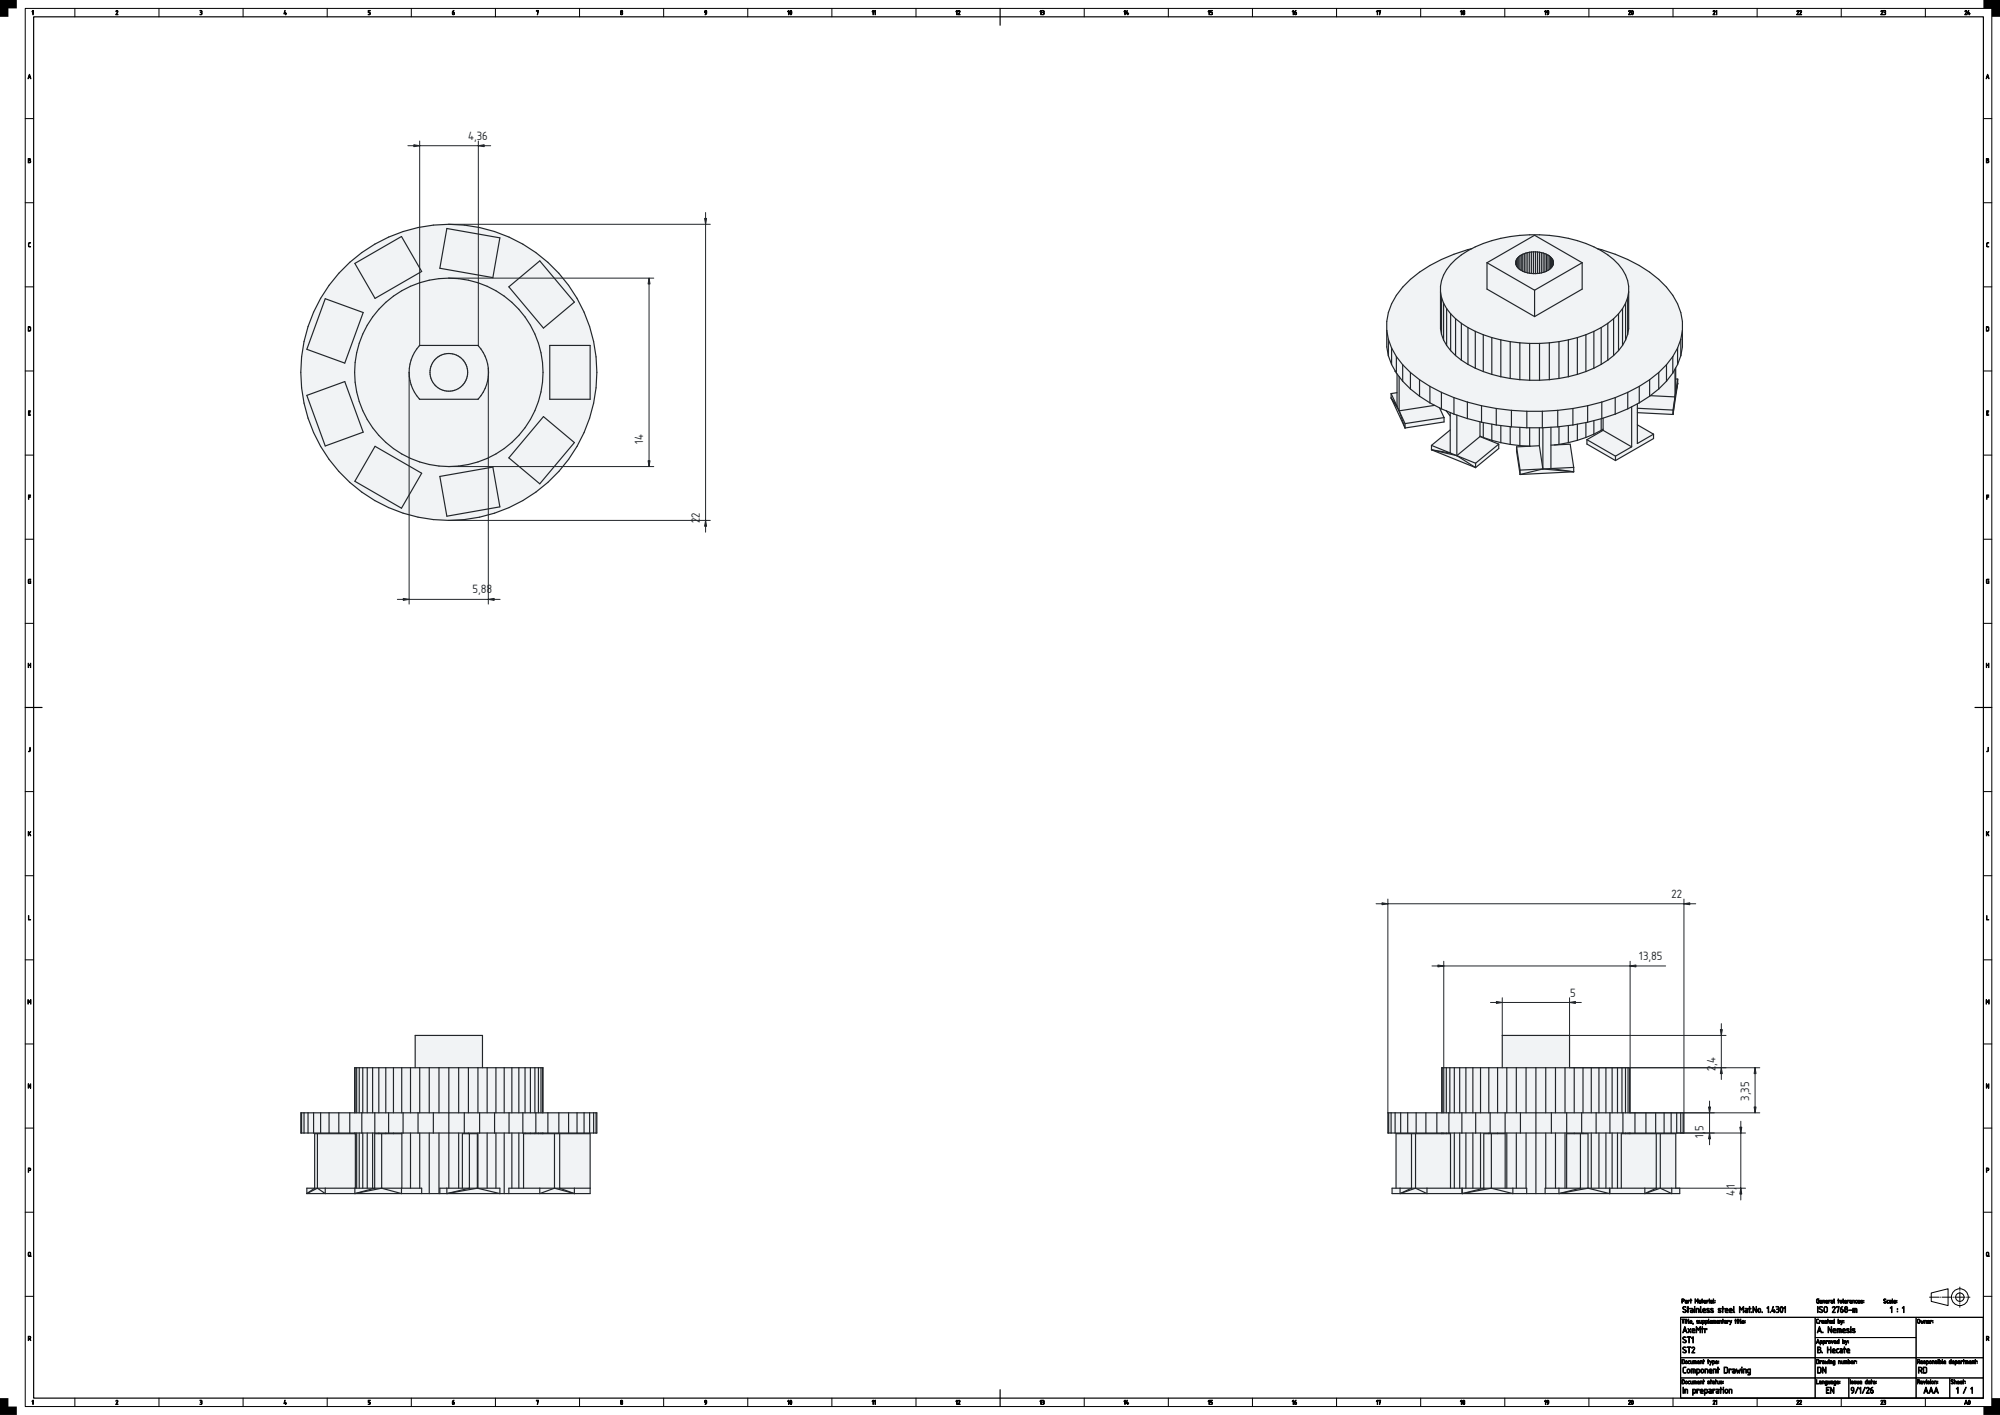
[picture p33: page 1]
