jagutic/SpiderBot/InformeTecnico/Planos/base.pdf

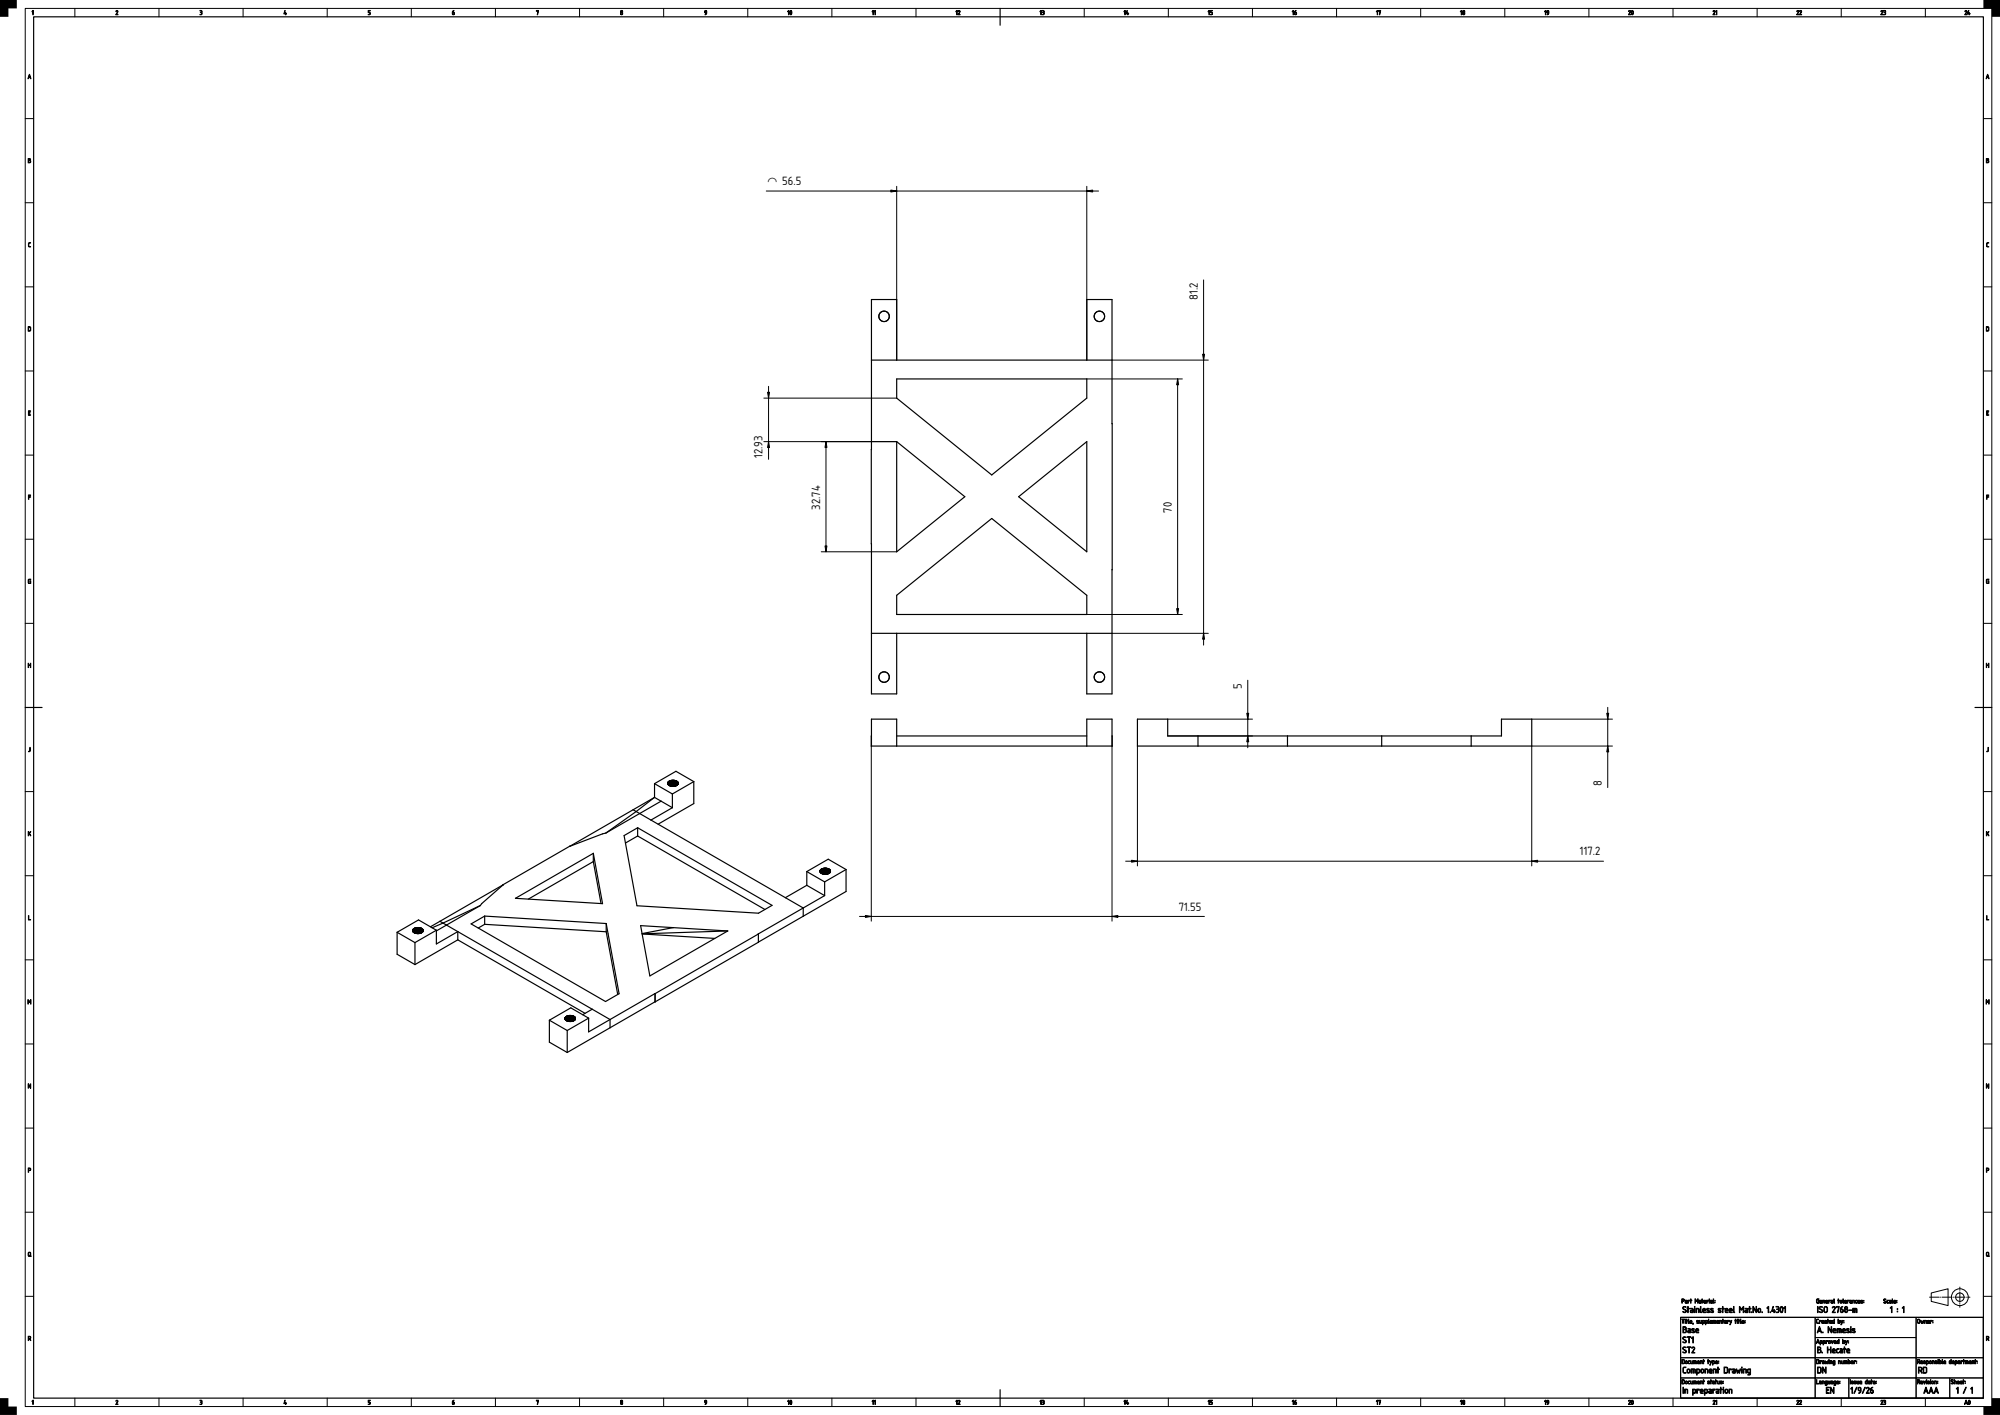
[picture p34: page 1]
