jagutic/SpiderBot/InformeTecnico/Planos/caja.pdf

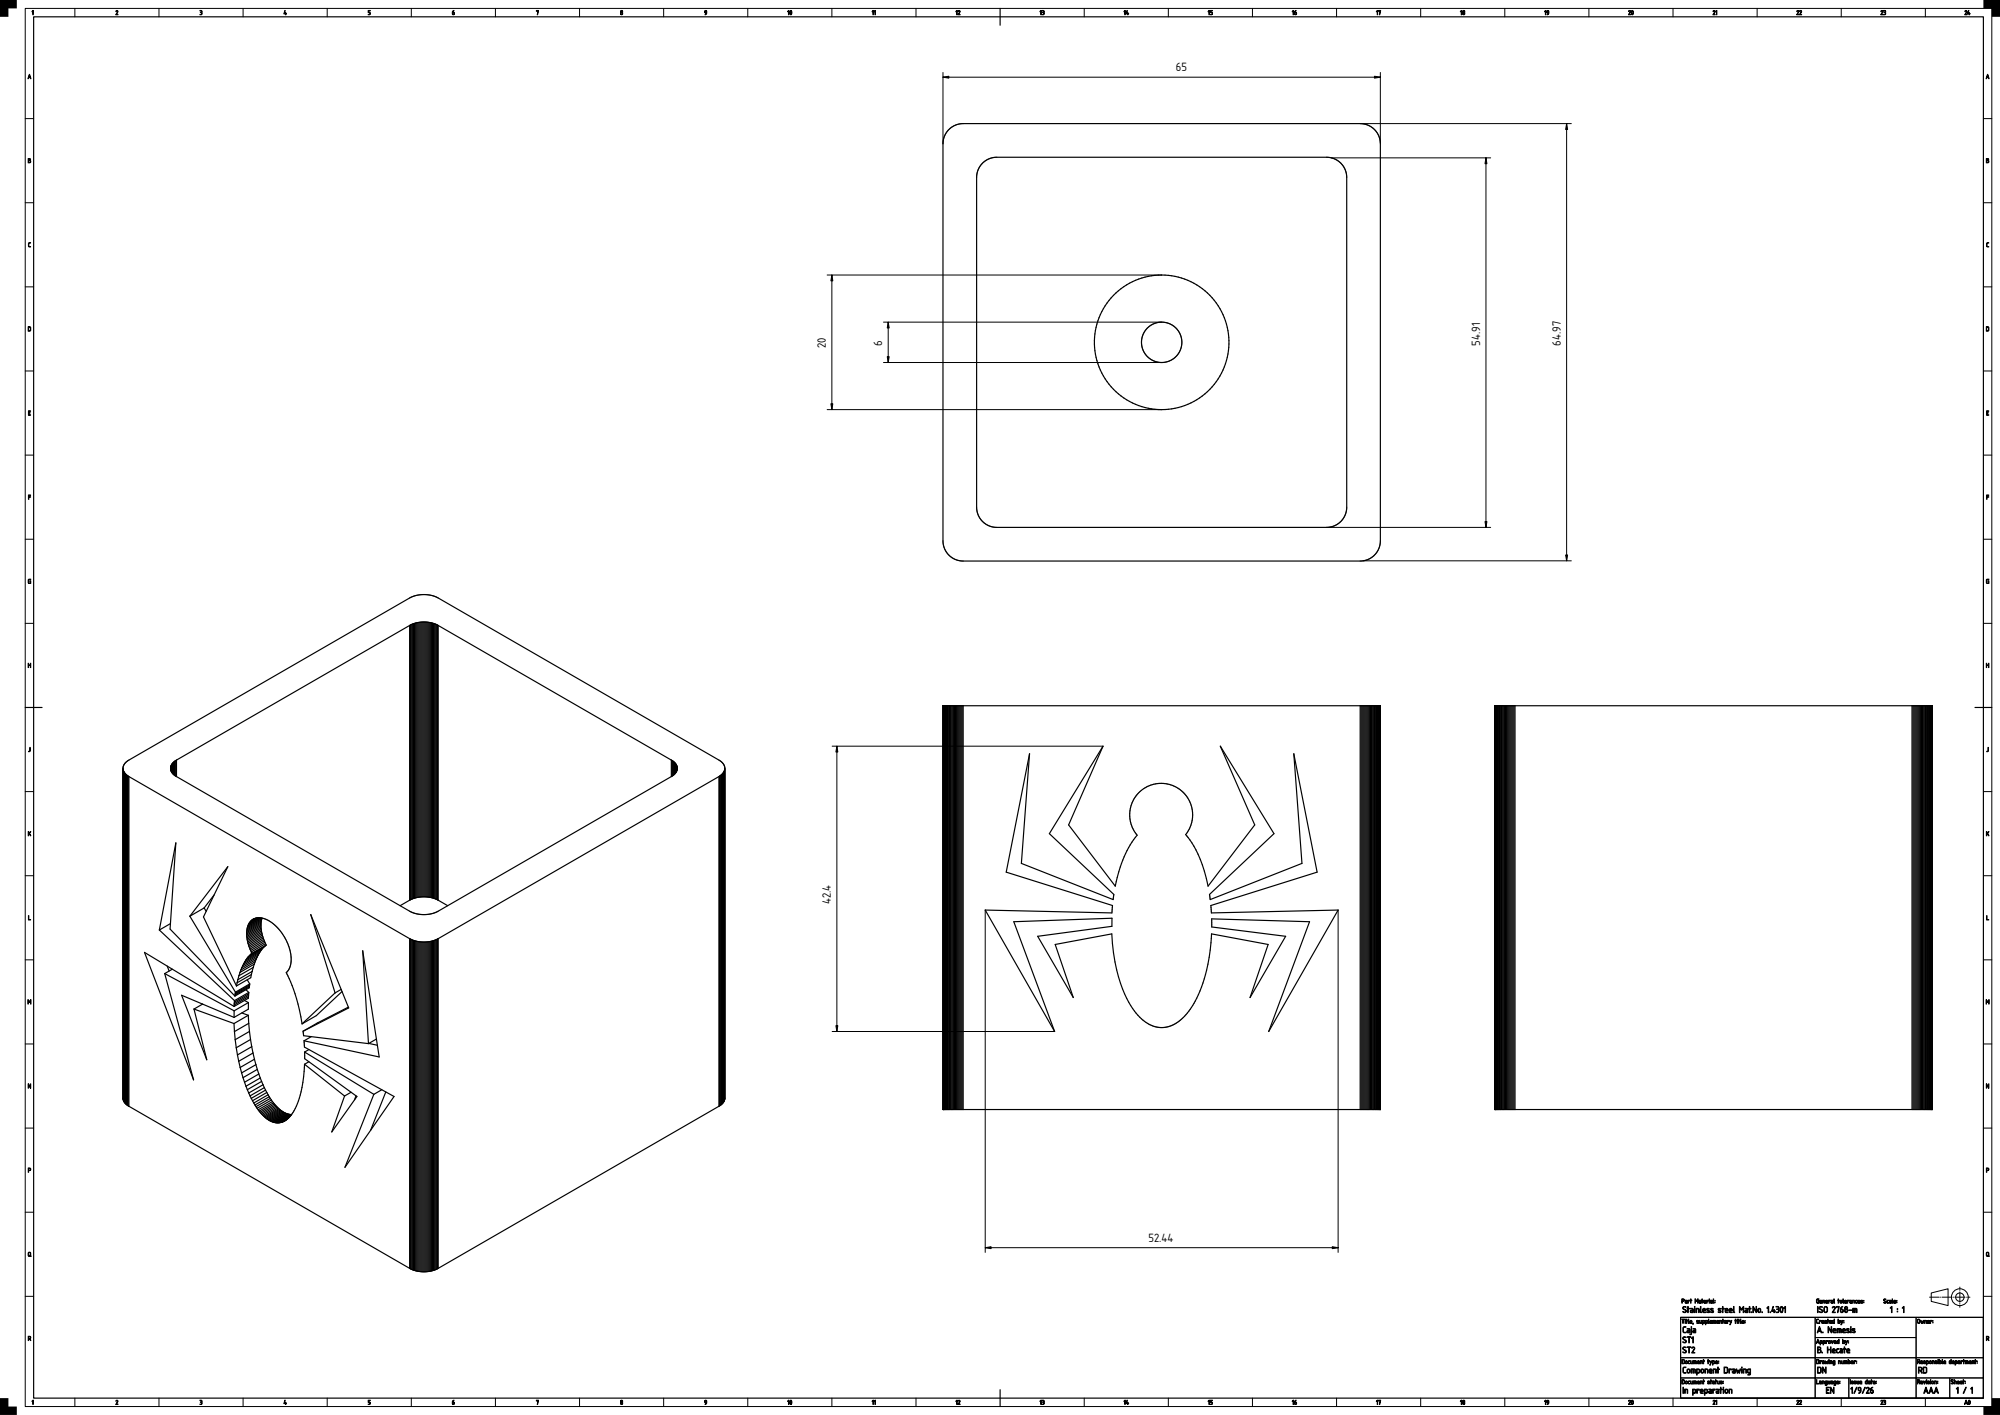
[picture p35: page 1]
