jagutic/SpiderBot/InformeTecnico/Planos/ClipWasher.pdf

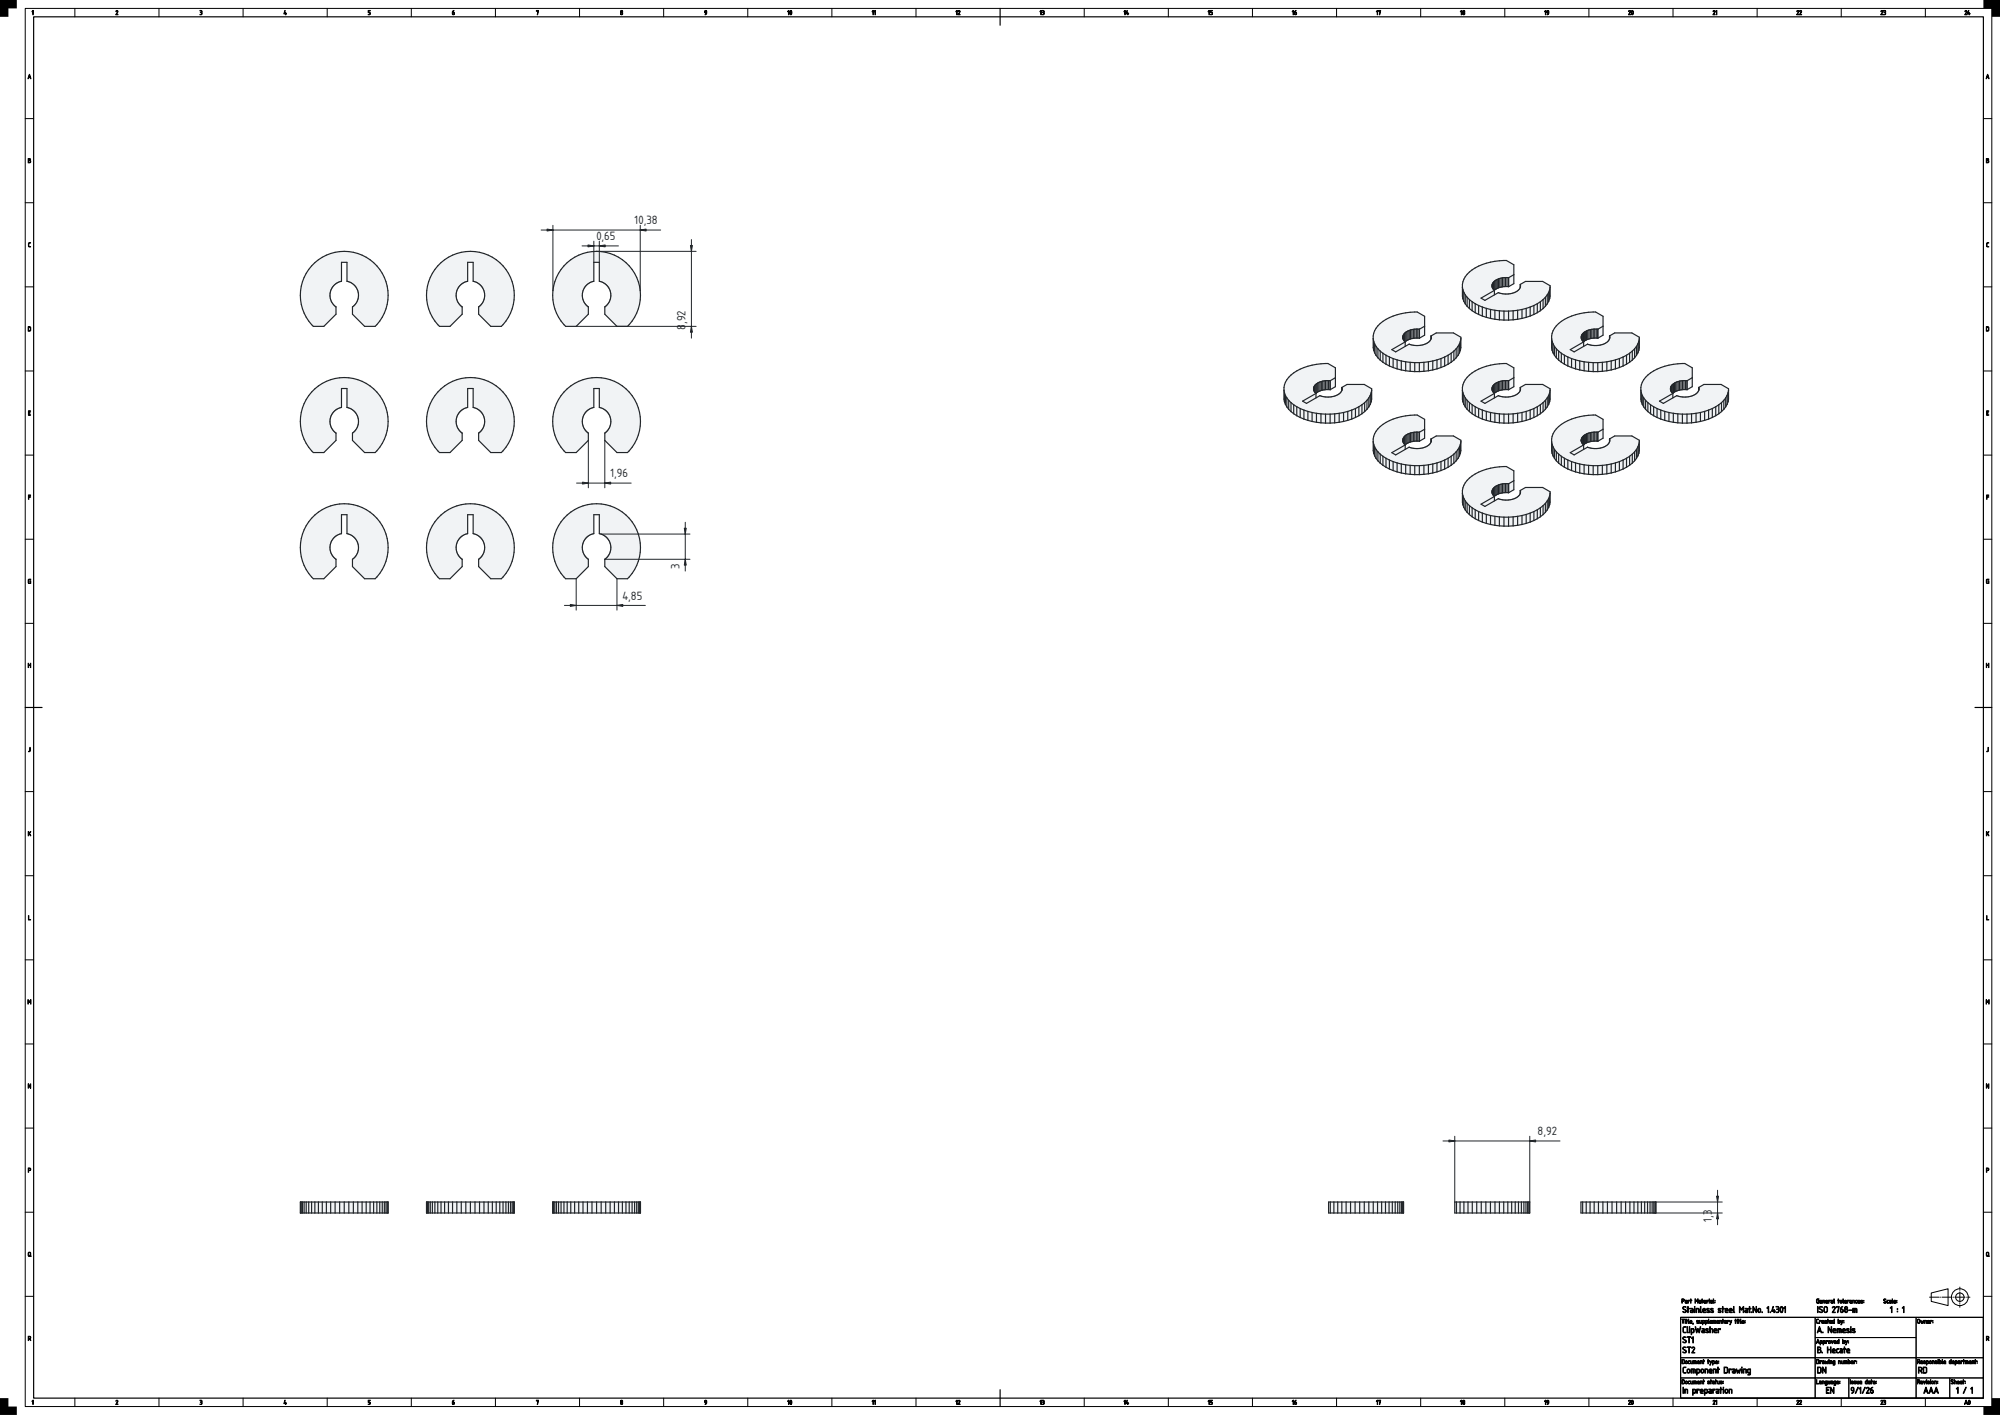
[picture p36: page 1]
