jagutic/SpiderBot/InformeTecnico/Planos/ClipWasherBig.pdf

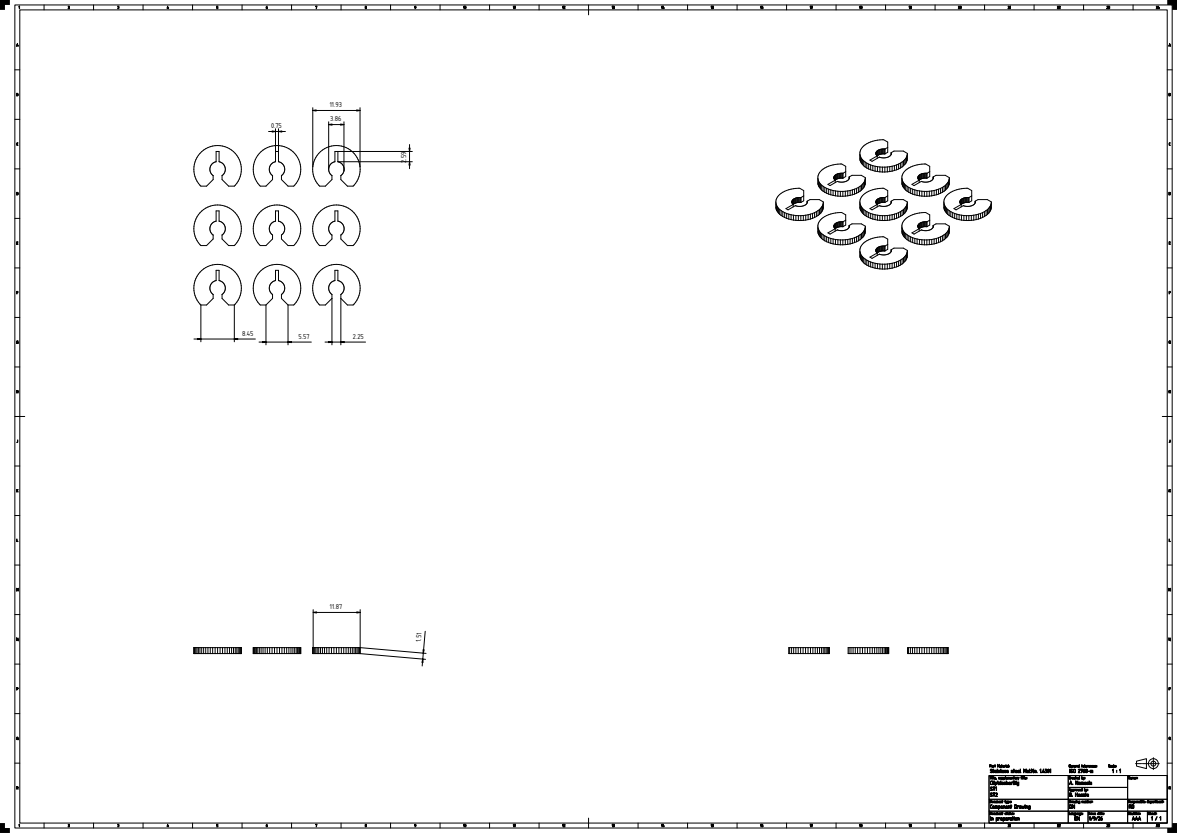
[picture p37: page 1]
