jagutic/SpiderBot/InformeTecnico/Planos/derecha.pdf

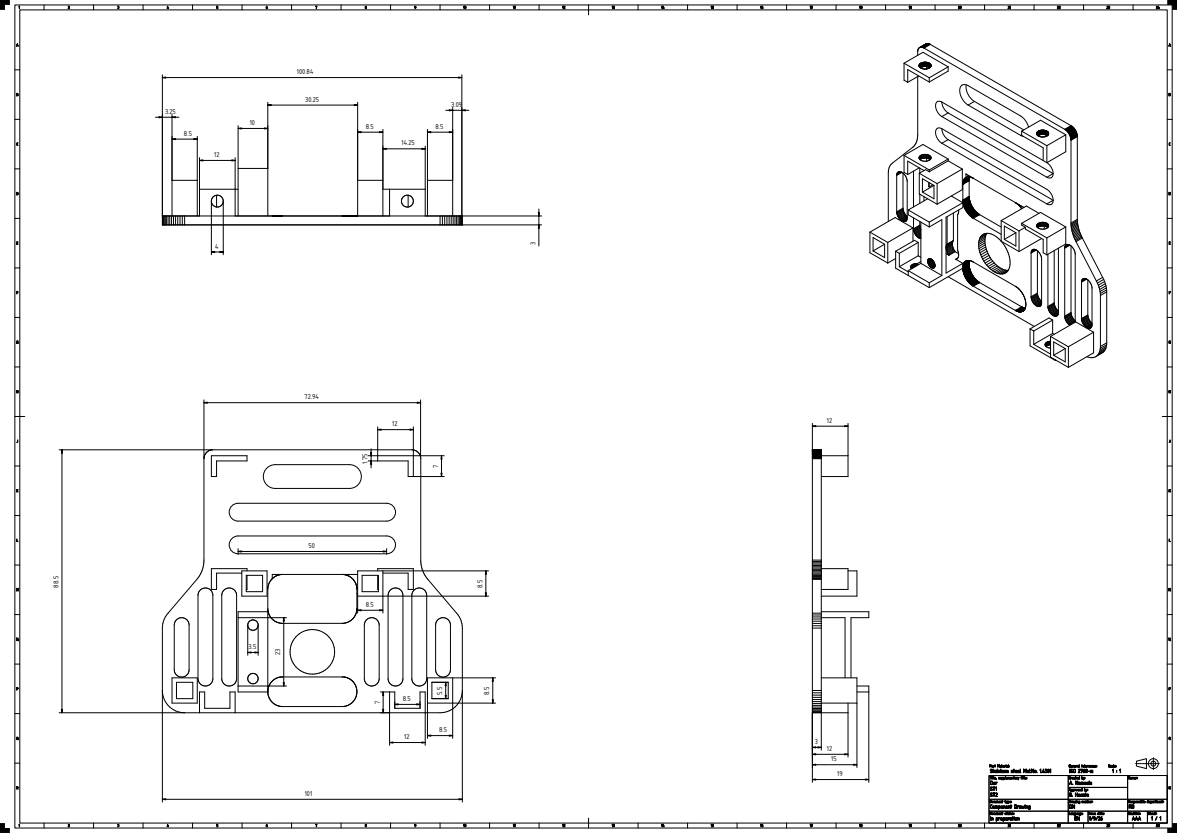
[picture p38: page 1]
