jagutic/SpiderBot/InformeTecnico/Planos/izquierda.pdf

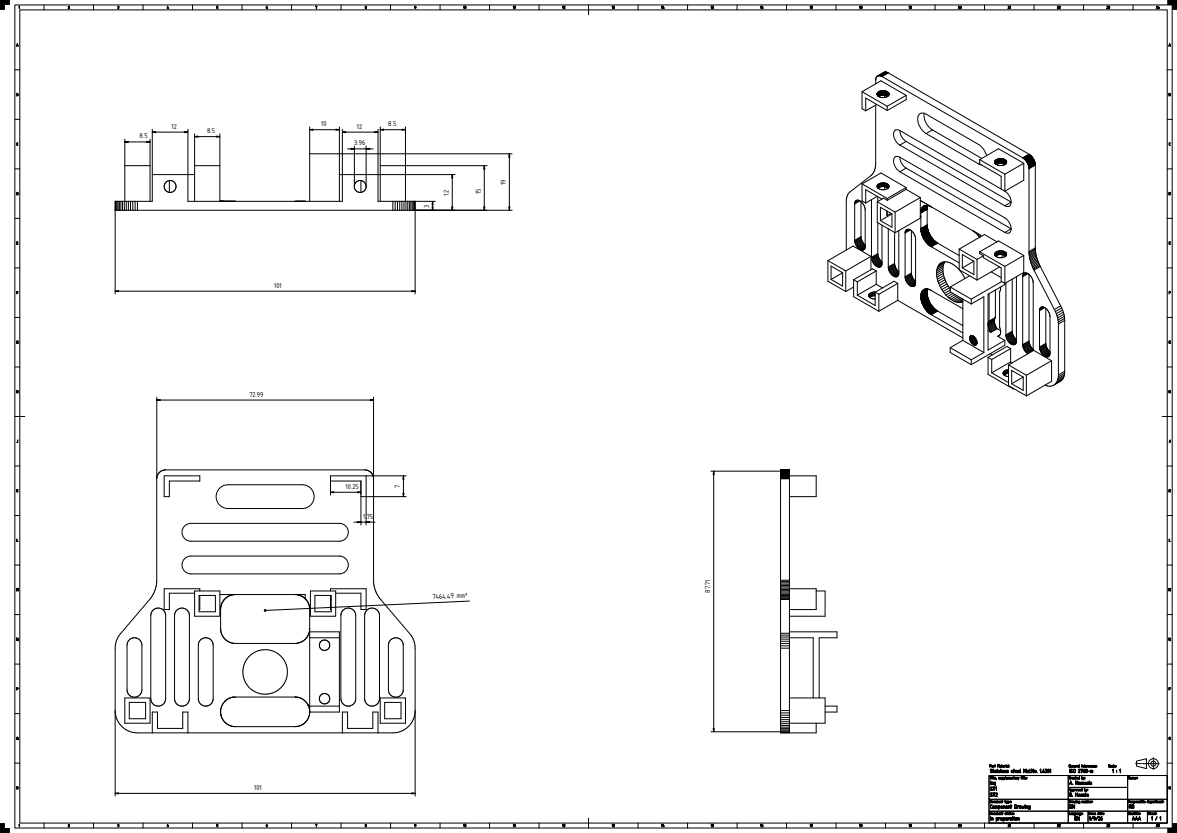
[picture p39: page 1]
7464.49 mm²
