jagutic/SpiderBot/InformeTecnico/Planos/Leg.pdf

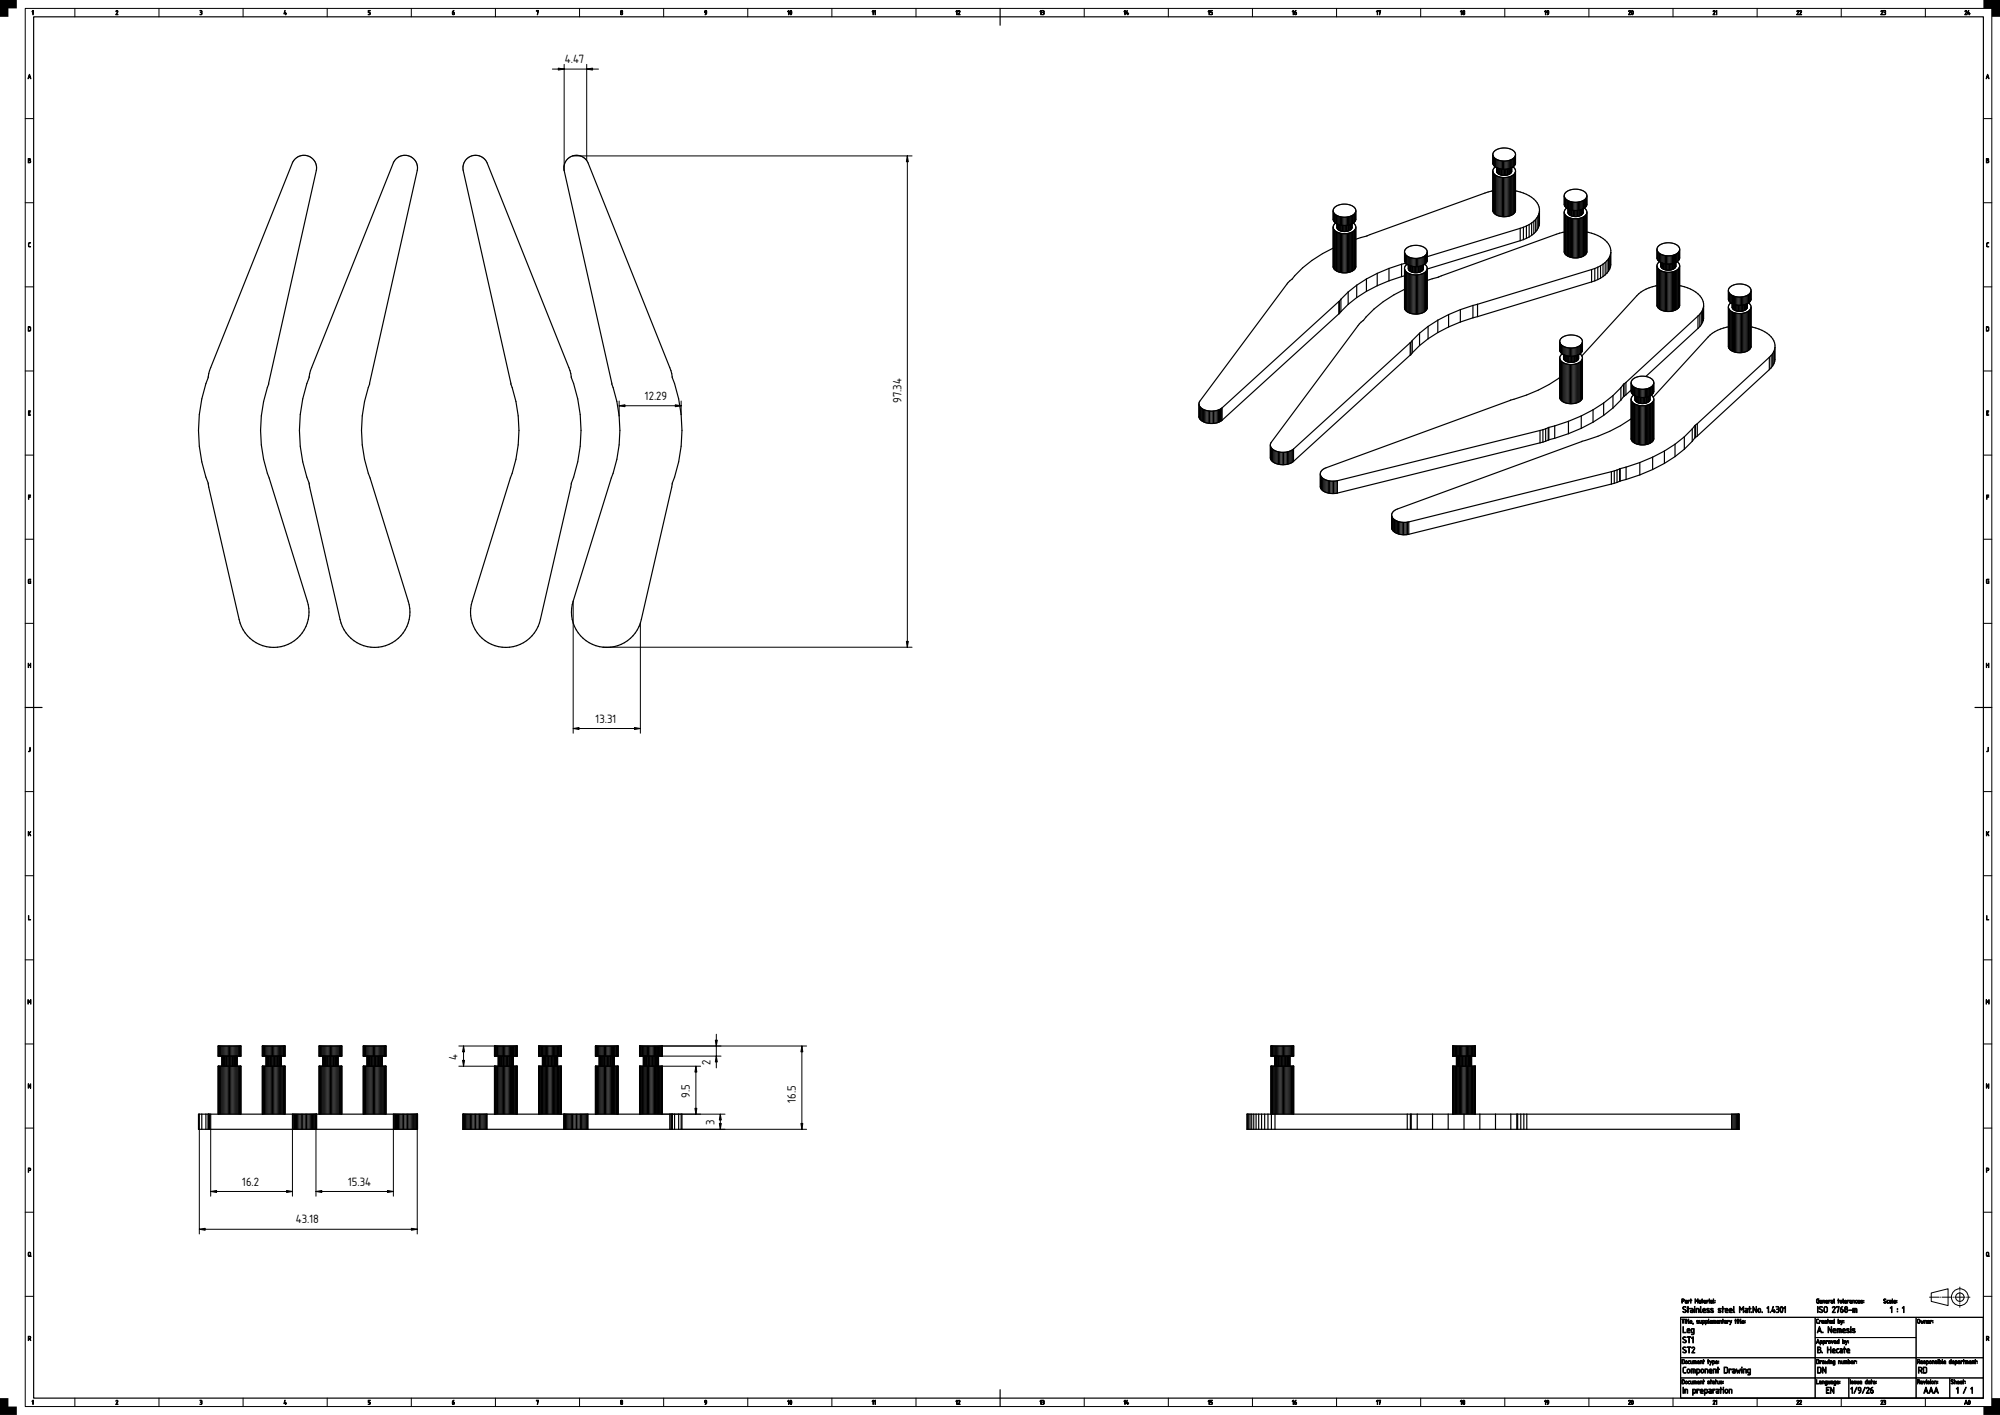
[picture p40: page 1]
