jagutic/SpiderBot/InformeTecnico/Planos/Link1.pdf

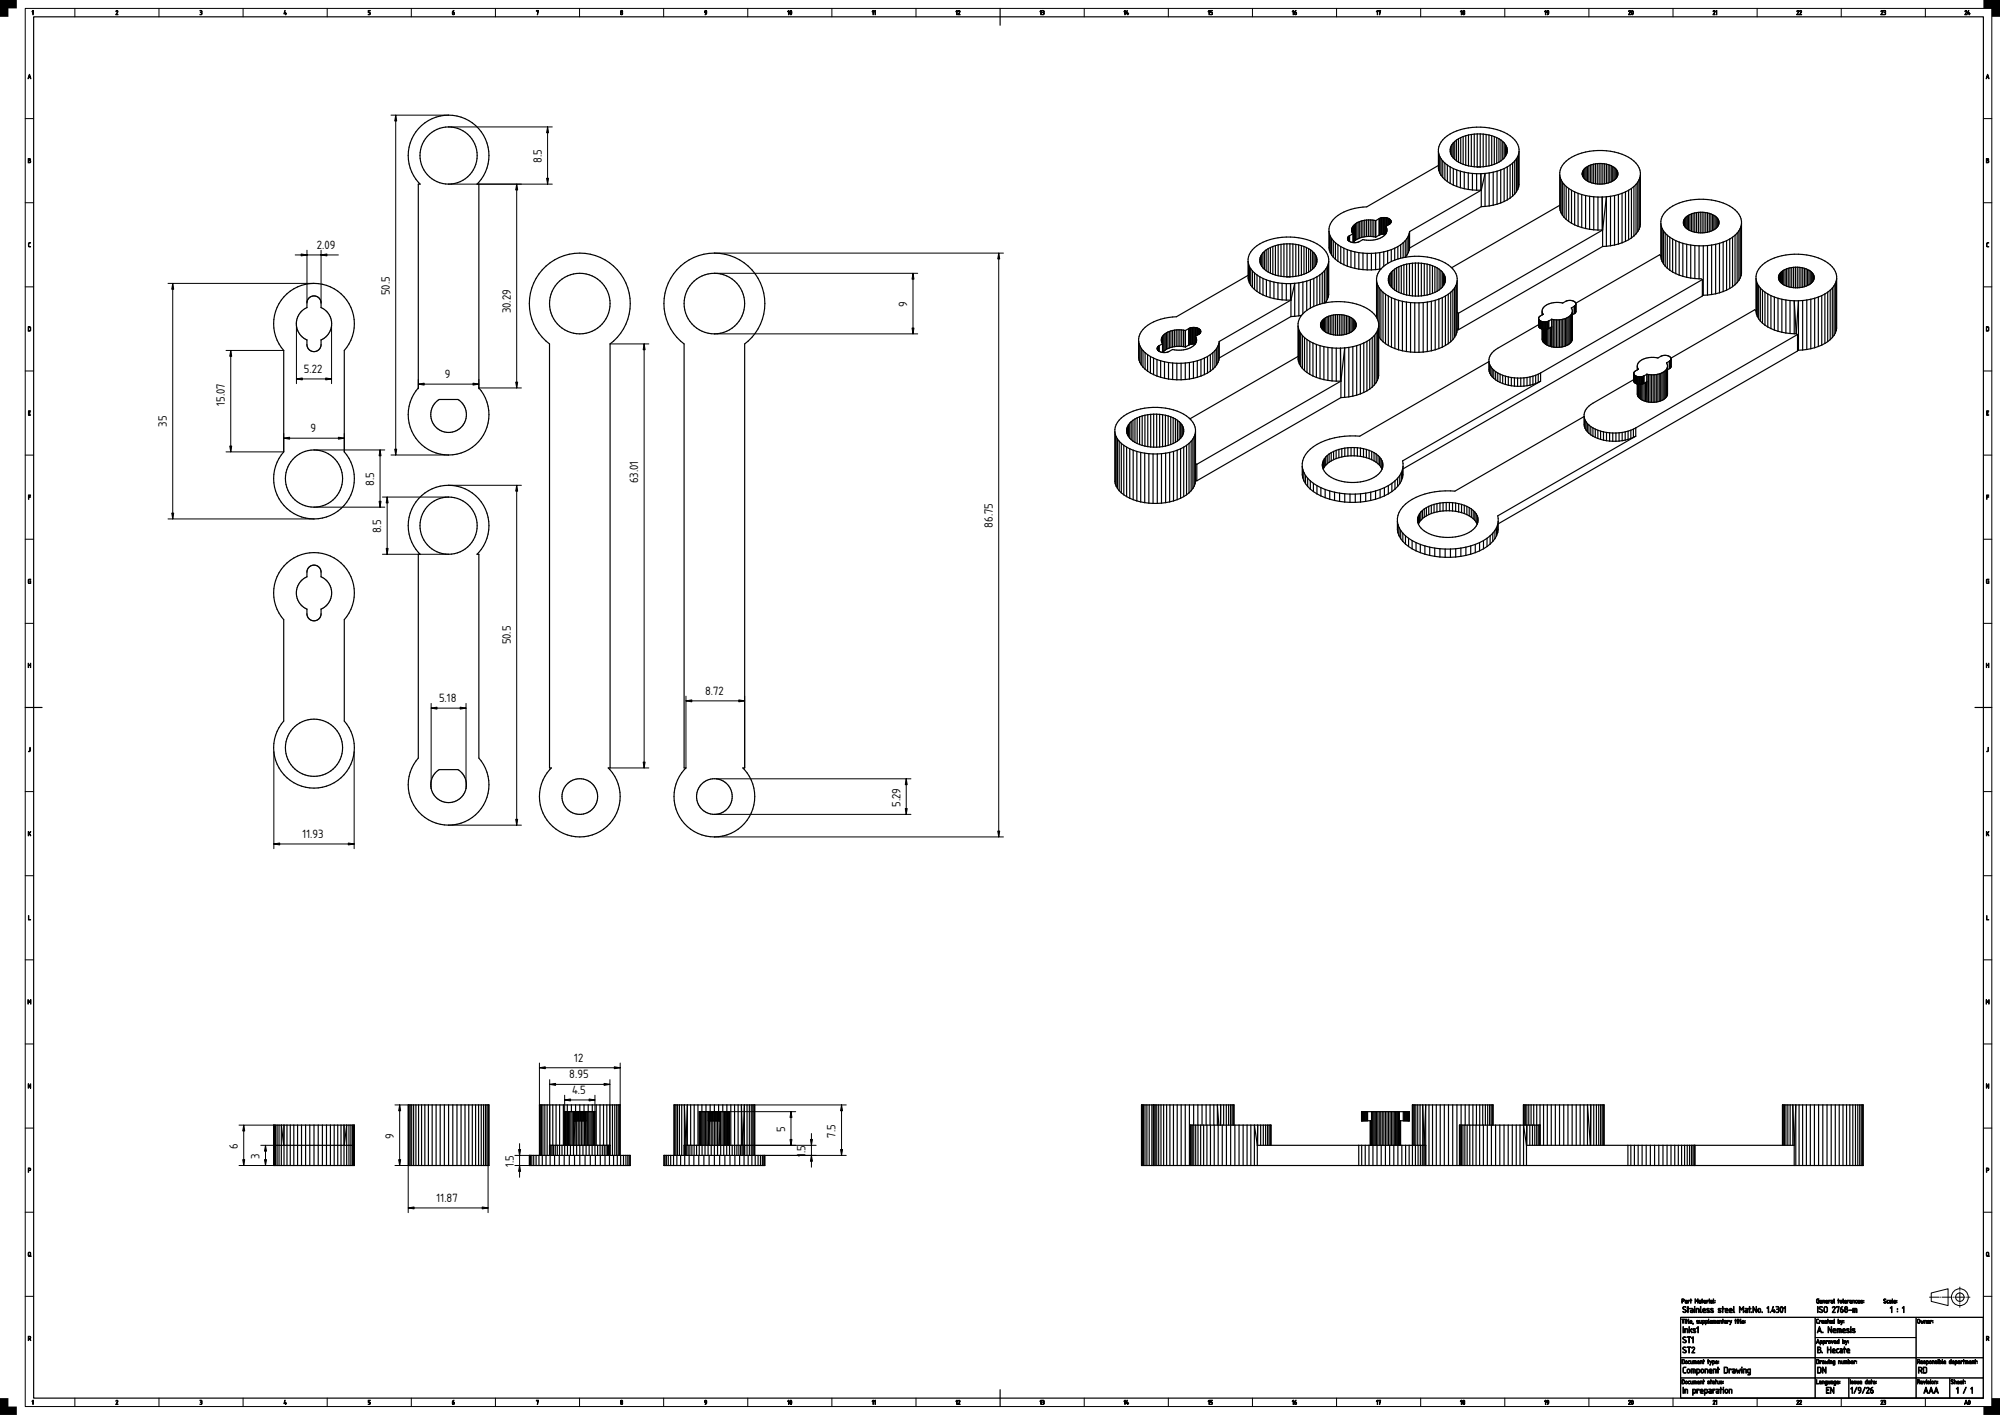
[picture p41: page 1]
