jagutic/SpiderBot/InformeTecnico/Planos/Link2.pdf

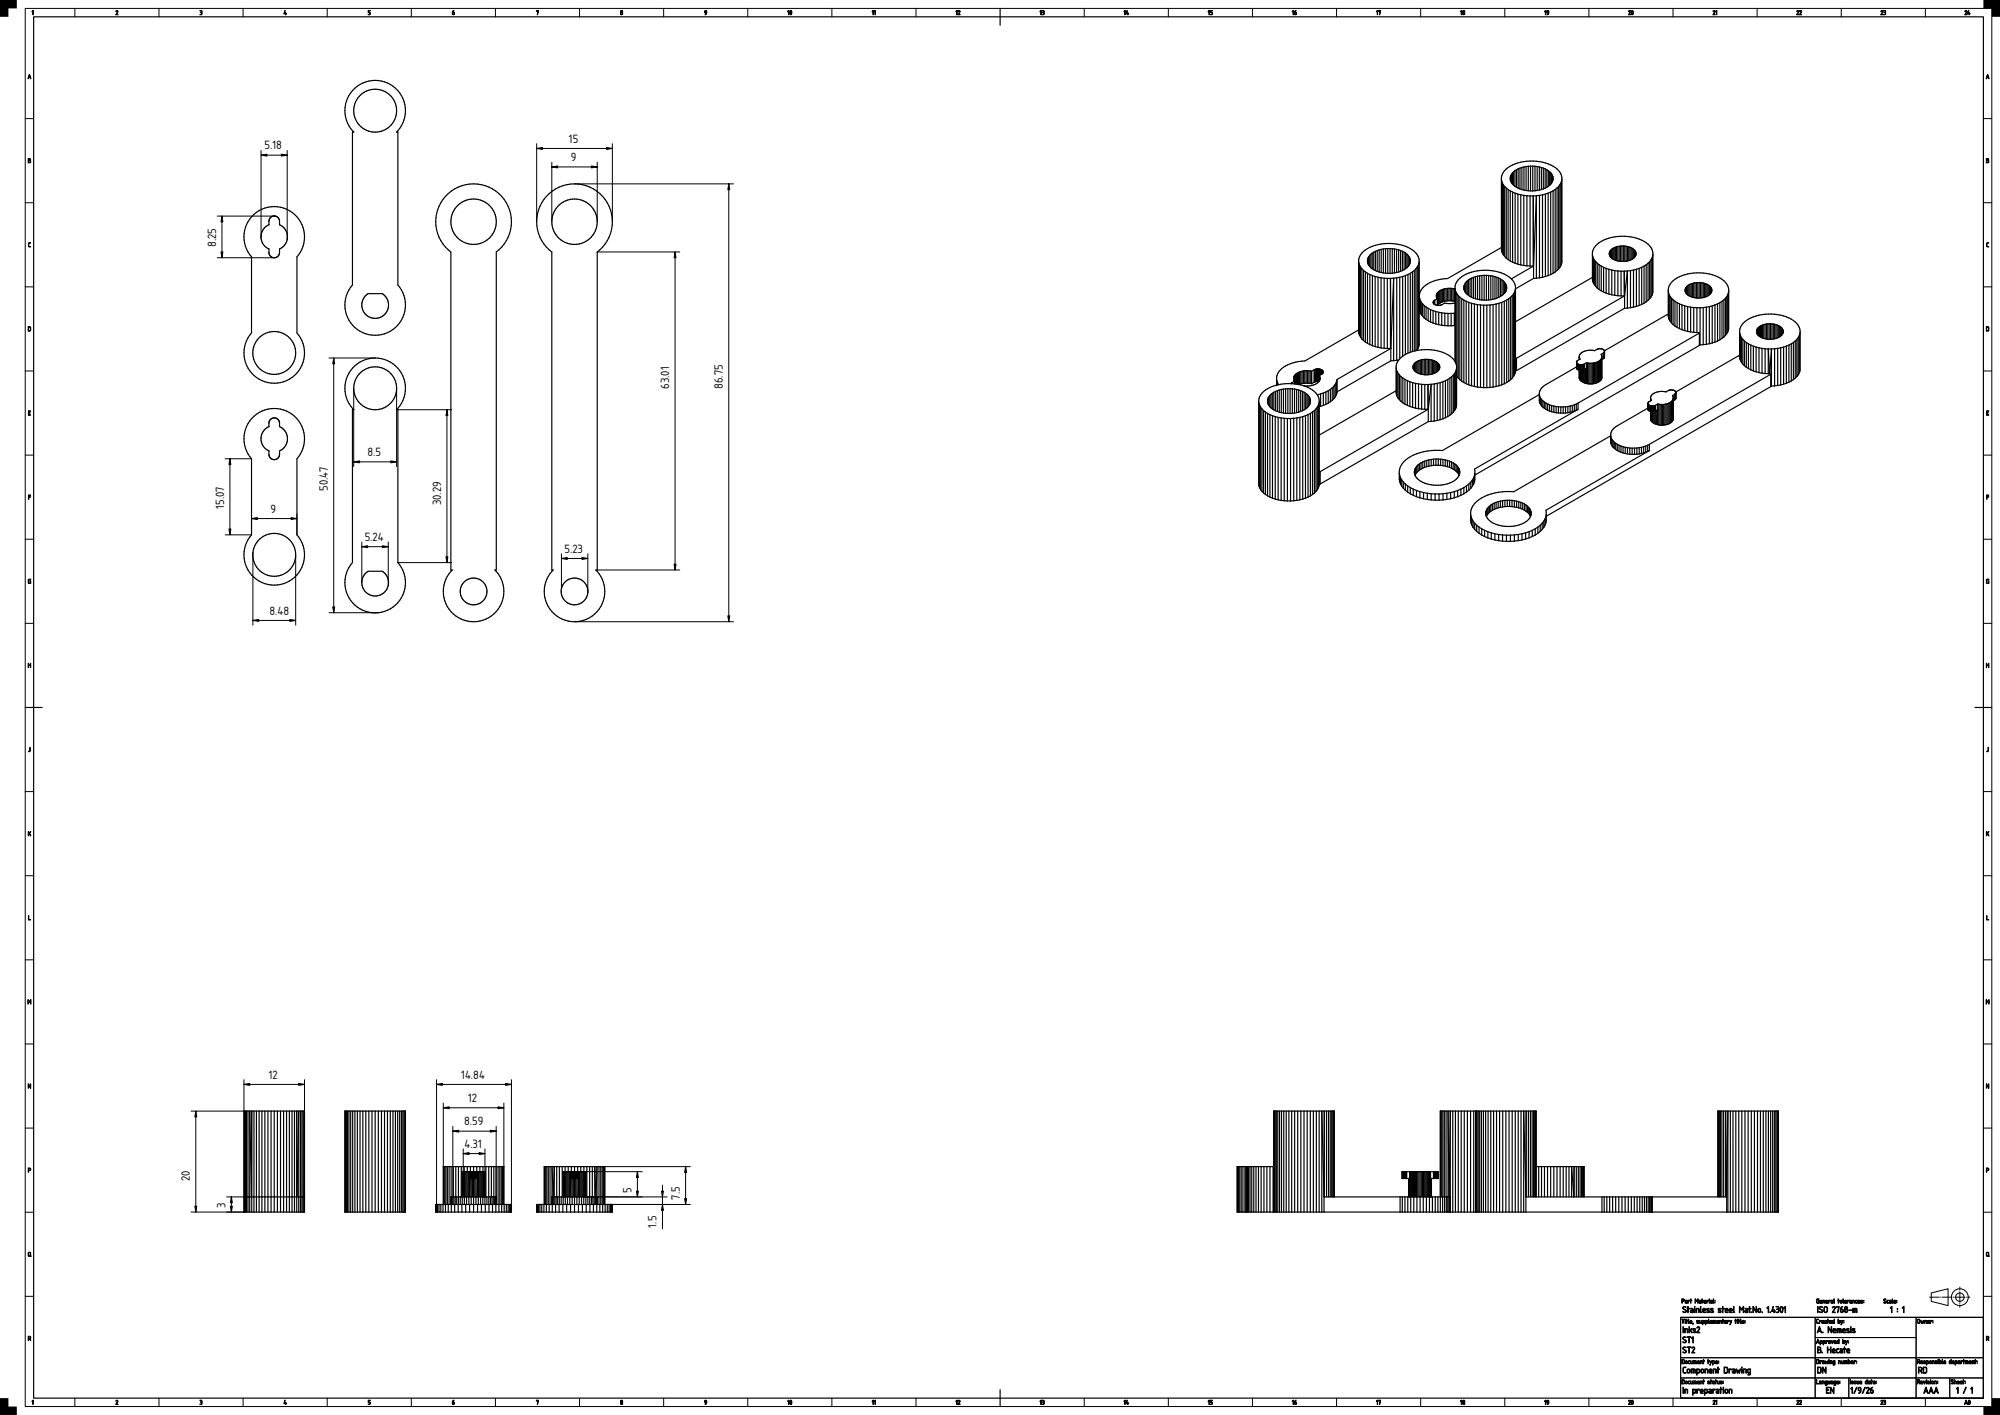
[picture p42: page 1]
