jagutic/SpiderBot/InformeTecnico/Planos/medio.pdf

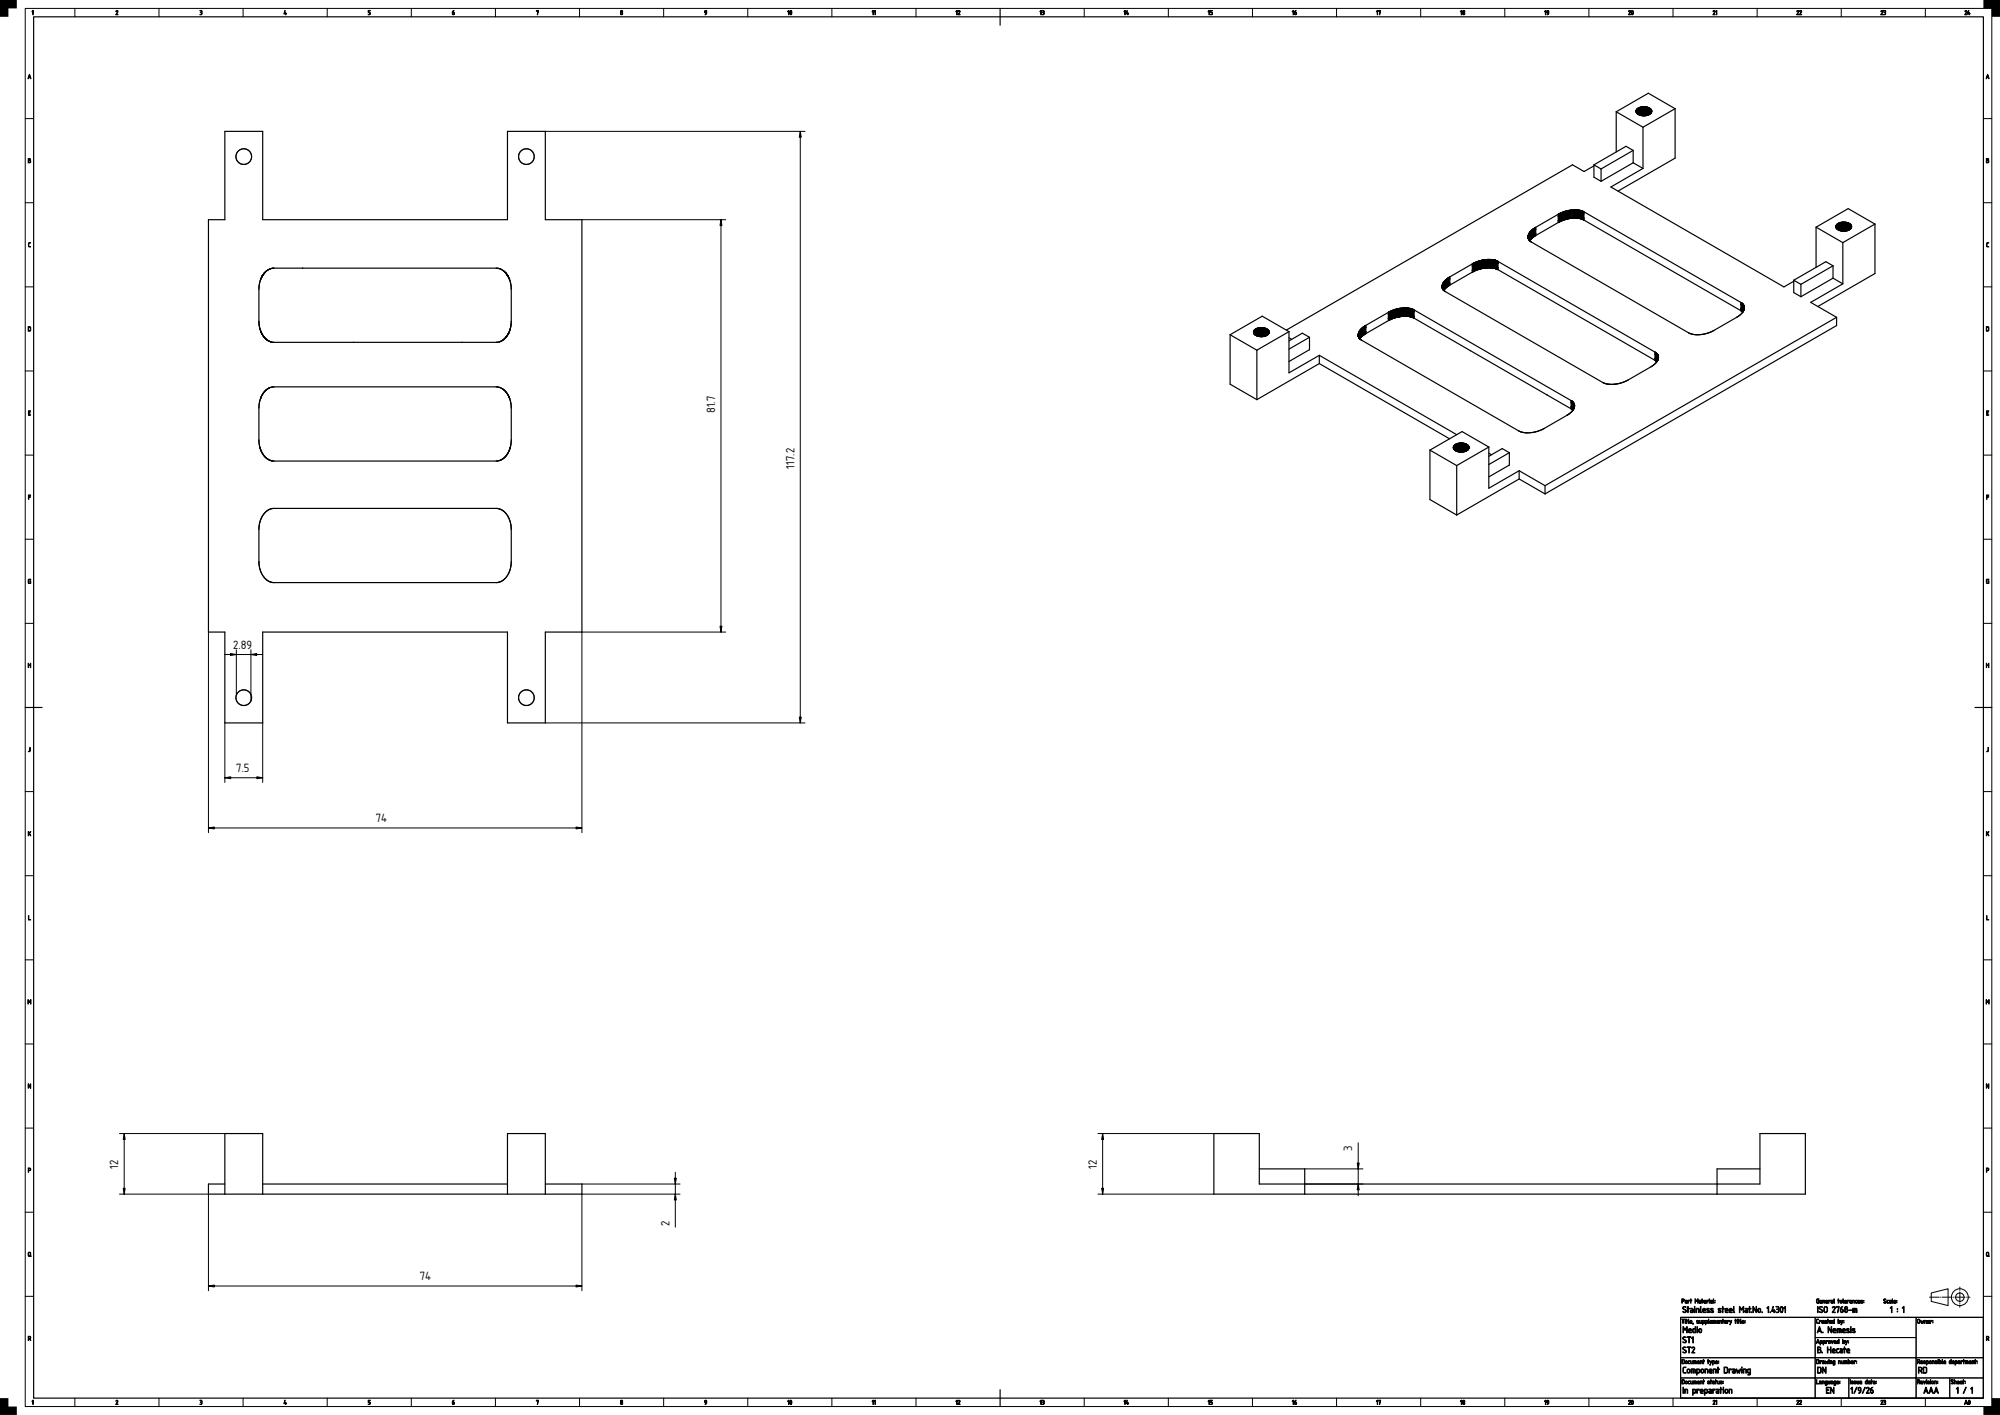
[picture p43: page 1]
