jagutic/SpiderBot/InformeTecnico/SpiderBot_KICAD/SPIDER_KICAD.kicad_pcb

## KiCad design InformeTecnico/SpiderBot_KICAD/SPIDER_KICAD.kicad_pcb (2026-01-03)

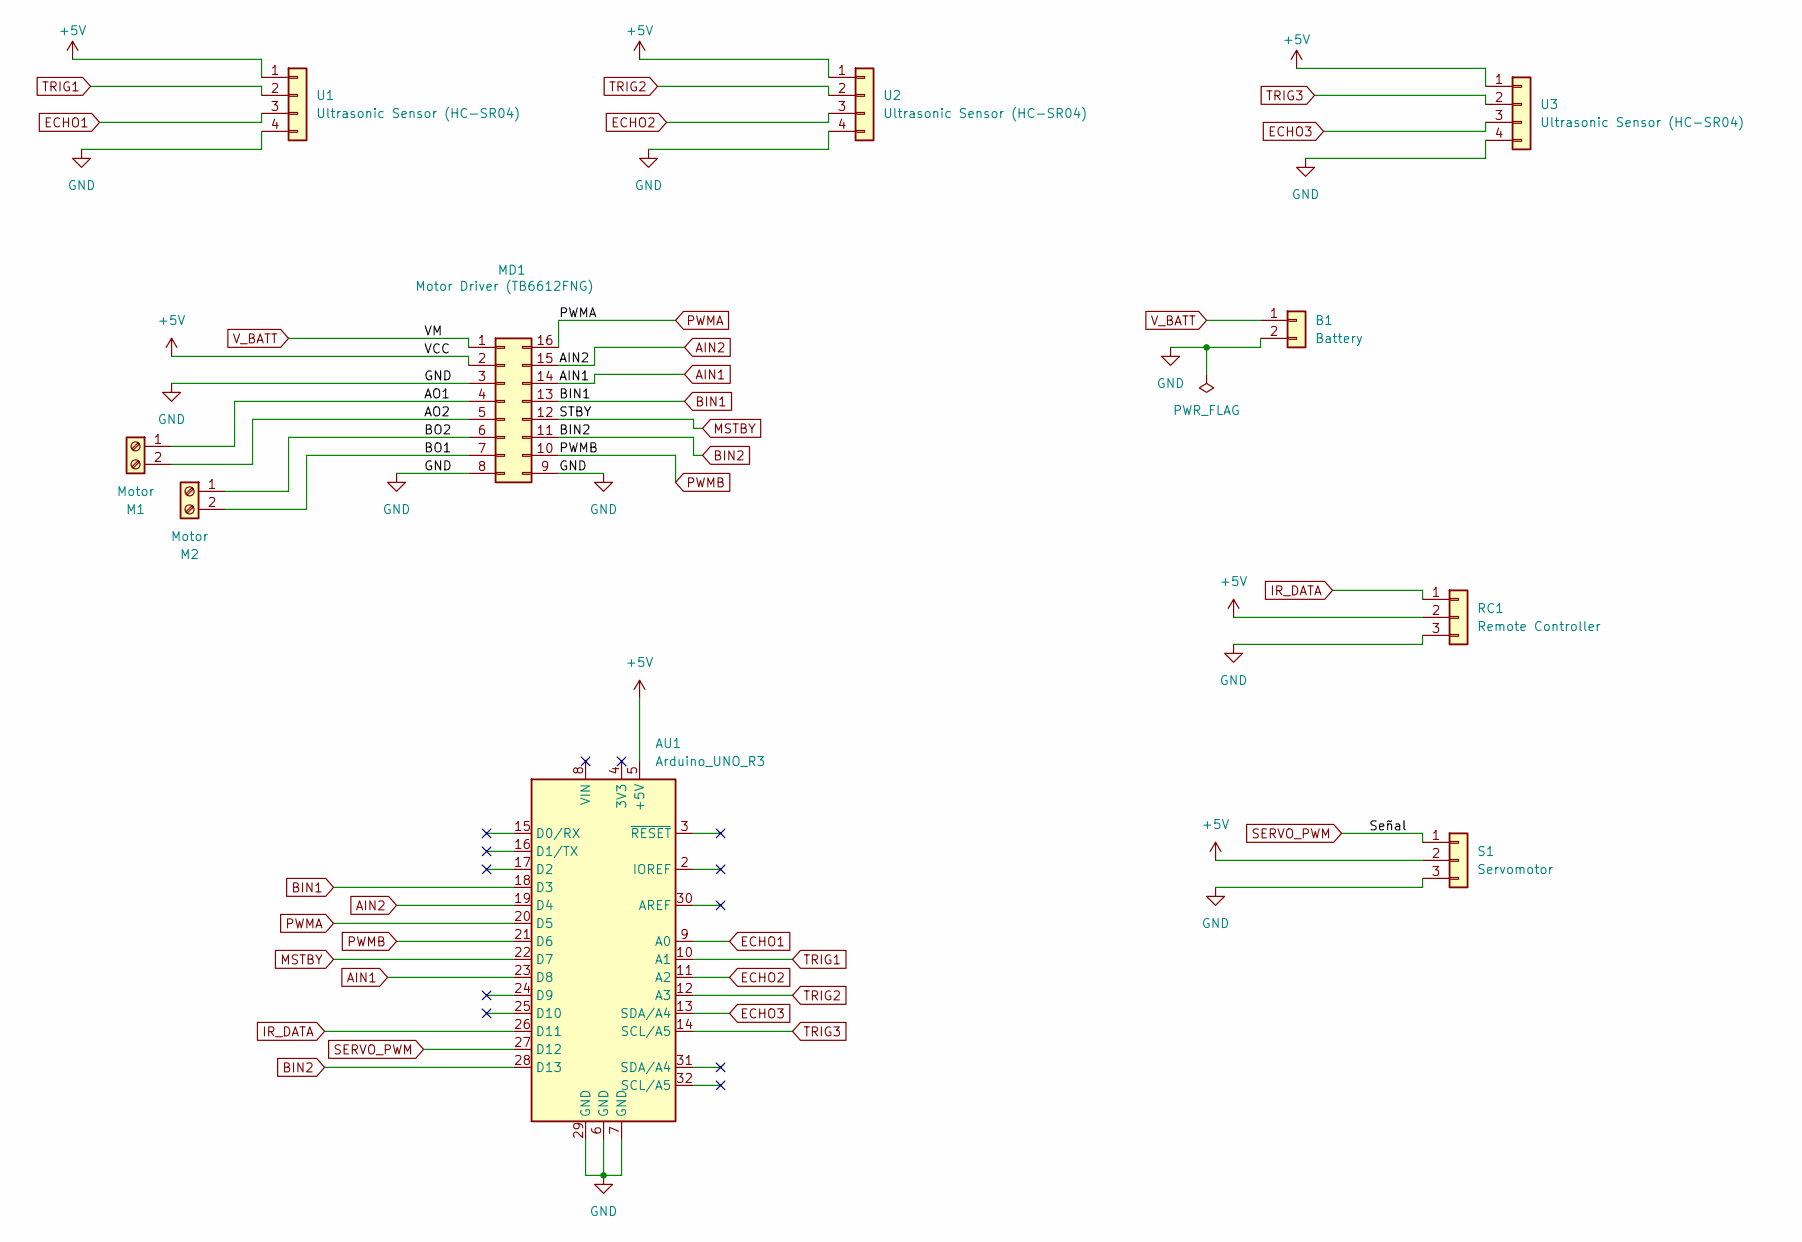
[picture p44: schematic SPIDER_KICAD.kicad_sch, SPIDER]

Parts:
AU1: Arduino_UNO_R3
B1: Battery; TerminalBlock_Phoenix_PT-1,5-2-5.0-H_1x02_P5.00mm_Horizontal
M1, M2: Motor; TerminalBlock_Phoenix_PT-1,5-2-5.0-H_1x02_P5.00mm_Horizontal
MD1: Motor Driver (TB6612FNG); PinHeader_2x08_P2.54mm_Vertical
RC1: Remote Controller; PinHeader_1x03_P2.54mm_Vertical
S1: Servomotor; PinHeader_1x03_P2.54mm_Vertical
U1, U2, U3: Ultrasonic Sensor (HC-SR04); PinHeader_1x04_P2.54mm_Vertical

Connections:
+5V: AU1.5 (+5V), MD1.2, RC1.2, S1.2, U1.1, U2.1, U3.1
AIN1: AU1.23 (D8), MD1.14
AIN2: AU1.19 (D4), MD1.15
BIN1: AU1.18 (D3), MD1.13
BIN2: AU1.28 (D13), MD1.11
ECHO1: AU1.9 (A0), U1.3
ECHO2: AU1.11 (A2), U2.3
ECHO3: AU1.13 (SDA/A4), U3.3
GND: AU1.6 (GND), AU1.7 (GND), AU1.29 (GND), B1.2, MD1.3, MD1.8, MD1.9, RC1.3, S1.3, U1.4, U2.4, U3.4
IR_DATA: AU1.26 (D11), RC1.1
MSTBY: AU1.22 (D7), MD1.12
unnamed: M1.1, MD1.4
unnamed: M1.2, MD1.5
unnamed: M2.1, MD1.6
unnamed: M2.2, MD1.7
PWMA: AU1.20 (D5), MD1.16
PWMB: AU1.21 (D6), MD1.10
SERVO_PWM: AU1.27 (D12), S1.1
TRIG1: AU1.10 (A1), U1.2
TRIG2: AU1.12 (A3), U2.2
TRIG3: AU1.14 (SCL/A5), U3.2
V_BATT: B1.1, MD1.1

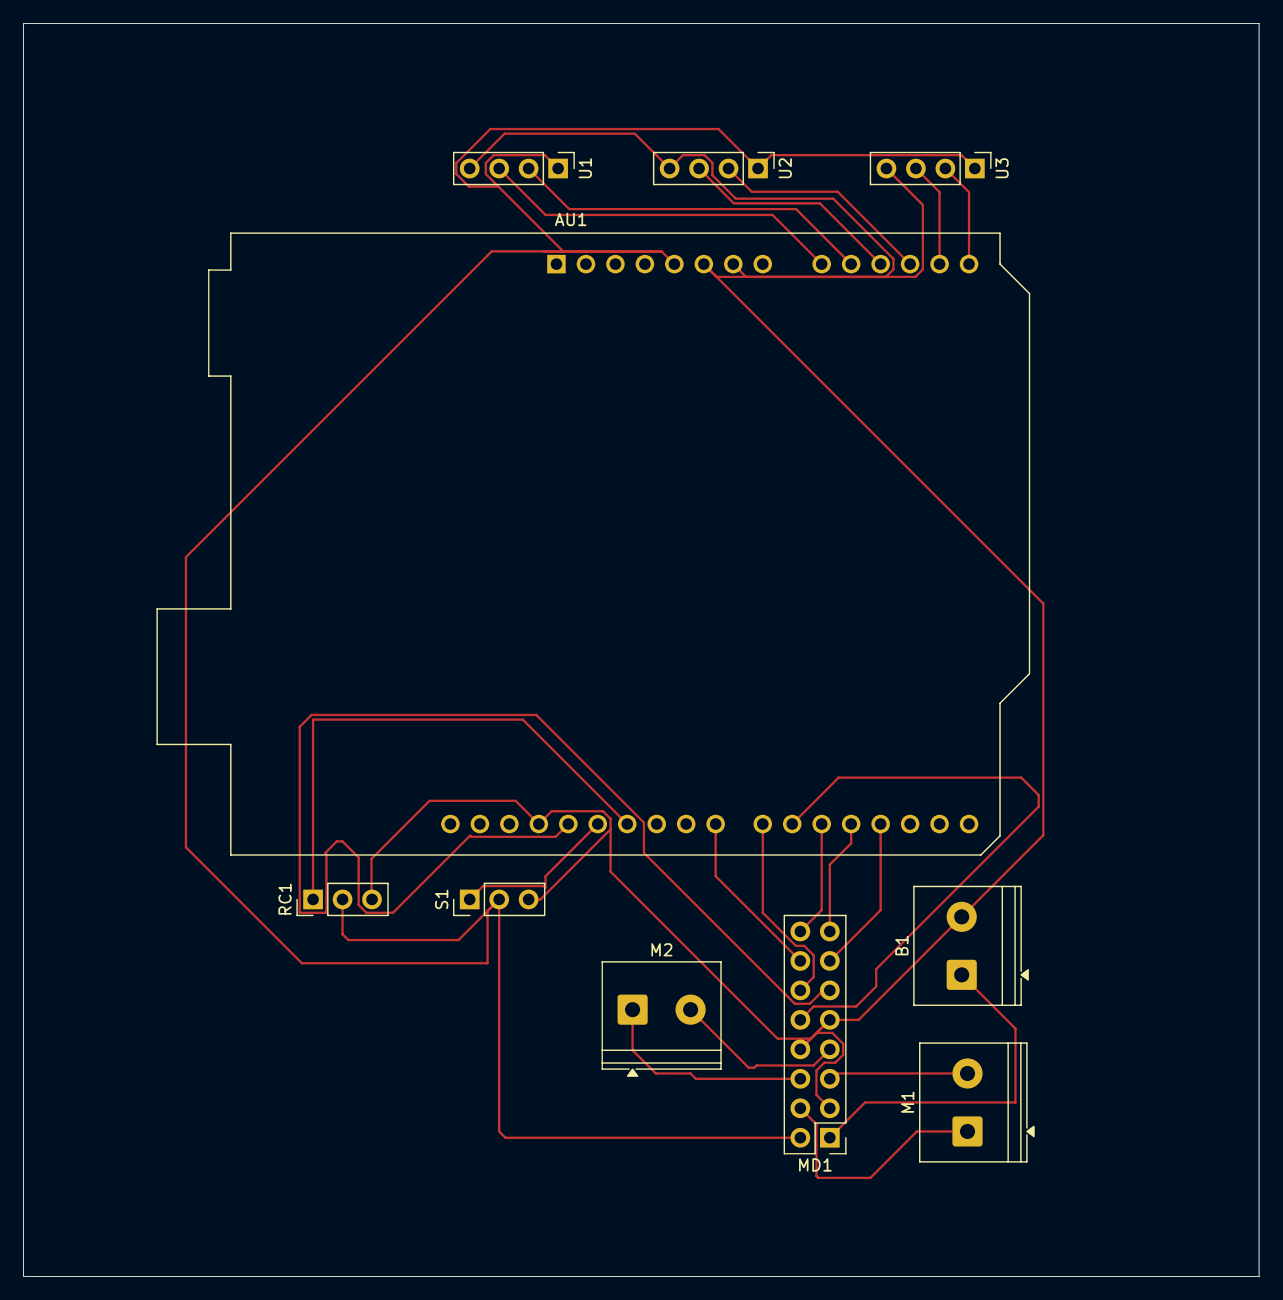
[picture p45: board SPIDER_KICAD.kicad_pcb from above]

Board: 2 copper layers, 106.5 x 108.0 mm, 10 parts (0 on the bottom side), 22 nets.
