jagutic/SpiderBot/(commit log)

2025-12-04 Indice de informe tecnico
2026-01-03 Expand sections on mechanical and electronic design
    Added detailed sections on mechanical and electronic design, including PCB design and Arduino code structure.
2026-01-03 Adicion imagenes y carpeta kicad
    [SPIDER_KICAD.kicad_pcb, SPIDER_KICAD.kicad_sch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]
2026-01-03 Update InformeTecnico with PCB manufacturing details
    Added details on PCB manufacturing and validation processes, including Gerber file generation and 3D assembly validation.
2026-01-05 Revise maintenance procedures for SpiderBot
    Updated maintenance manual for SpiderBot, clarifying battery care, mechanical structure inspection, and troubleshooting steps.
2026-01-07 Separar en carpetas y añadir stls
    [Arriba.stl, AxeDrive.stl, AxeMain.stl, AxeMtr.stl, CAJA SENSOR ULTRA SONIDO.stl, Caja.stl, ClipWasher.stl, ClipWasherBig.stl]
2026-01-07 Borrar arcihvos movidos
    [SPIDER_KICAD.kicad_pcb, SPIDER_KICAD.kicad_sch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]
2026-01-07 Renombrar stls
    [CajaUS.stl, TapaUS.stl]
2026-01-07 Cambiar Caja y fotos
    [Caja.stl]
2026-01-08 Insert image for IR remote control section
    Added image for IR remote control in README.
2026-01-08 Enhance README with manual control instructions
    Added detailed instructions for manual control mode and button functions.
2026-01-08 Enhance README with simulation and design details
    Added detailed explanation of simulation challenges and URDF limitations.
2026-01-08 Informe de Autoevaluacion
2026-01-08 Revise README with design and assembly updates
    Updated the README to reflect changes in the robot's design and assembly instructions, including modifications to the 3D models and simulation details.
2026-01-09 Base y medio stl subidos
    [Base.stl, Medio.stl]
2026-01-09 Planos añadidos
    [CajaUS.stl, TapaUS.stl]
2026-01-09 Fix sensor type in troubleshooting table
    Updated troubleshooting table to reflect changes in sensor type for obstacle avoidance.
